WesternHAB/BioSampleBalloon/README.md

Bioaerosol Sampling Balloon
=======

Files and flight computer code for the 2019 bioaerosol sampling balloon, to be launched in August 2019

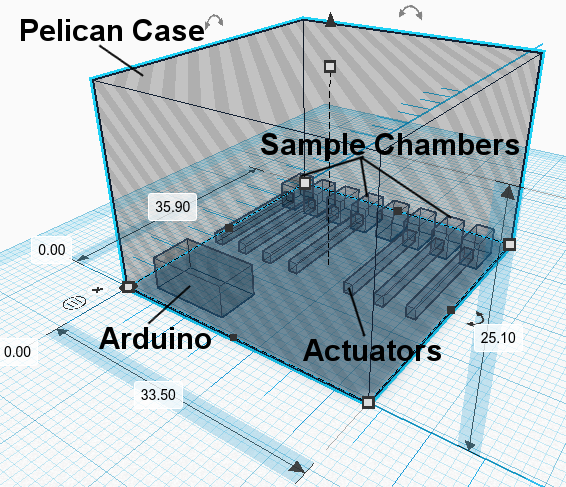
[picture p1: pdrreport/diagrams/payloadlayout_annot.png]
sketch of payload
