WesternHAB/BioSampleBalloon/pdrreport/diagrams/pdr.md

experimental design and procedures:
	* full system spec and diagrams
		* sample chamber
			* design of 1
			* how they all fit into the pelican case
		* computer arduino mega 2560
			shield provides ethernet and sd card
	* pre-flight
		* cooling test with less insulation to simulate colder temperatures
