WesternHAB/BioSampleBalloon/meetings/feb27.md

design meeting
===========

* over center latch design
https://www.amazon.ca/Southco-97-30-160-12-Over-Center-Series-Latches/dp/B013RO3R14/
* bag squeezed on lid
* push pen design
* need solidworks drawings

* rotorod dimensions 22mm x 1.6mm
