WesternHAB/BioSampleBalloon/pdrreport/COM.ods

reference point: | back left of pelican case, nearest to the chambers
case dimensions | X= 33.5cm | Y = 35.9cm | Z = 25.9
payload component | mass (g)
chambers | 7614.72
actuators | 770
arduino | 227
total mass | 8611.72
component position | x (cm) | y (cm) | z (cm)
chambers | 16 | 5.5 | 2
actuators | 16 | 19 | 2
arduino | 5.1 | 29.7 | 2
 | x (cm) | y (cm) | z (cm)
center of mass: | 14.15 | 4.86 | 1.77
