WesternHAB/BioSampleBalloon/IMG_20190429_135801.jpg

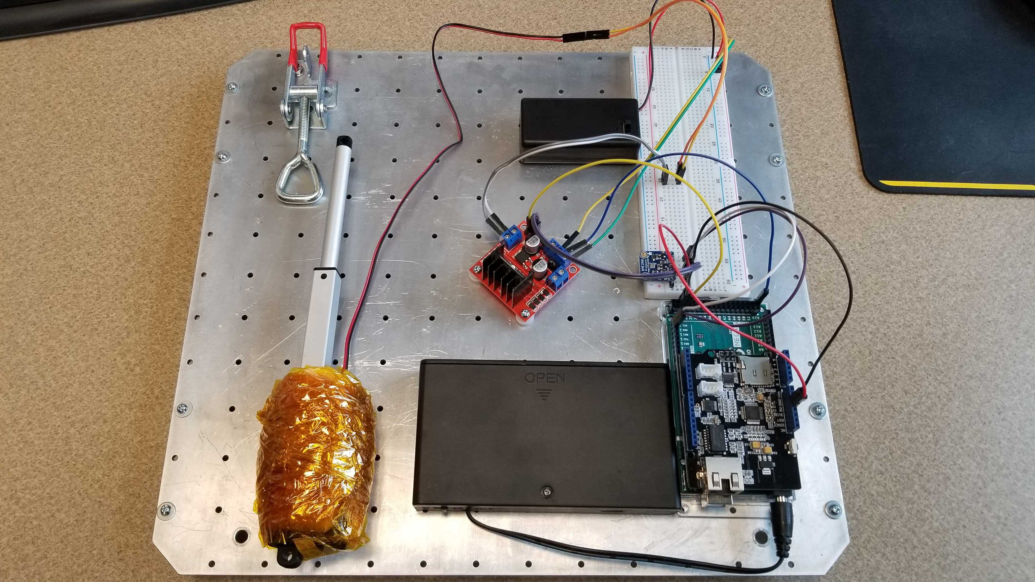
IMG_20190429_135801.jpg
