WesternHAB/BioSampleBalloon/PayloadDesign/61966530_412056996304490_6517414697593995264_n.jpg

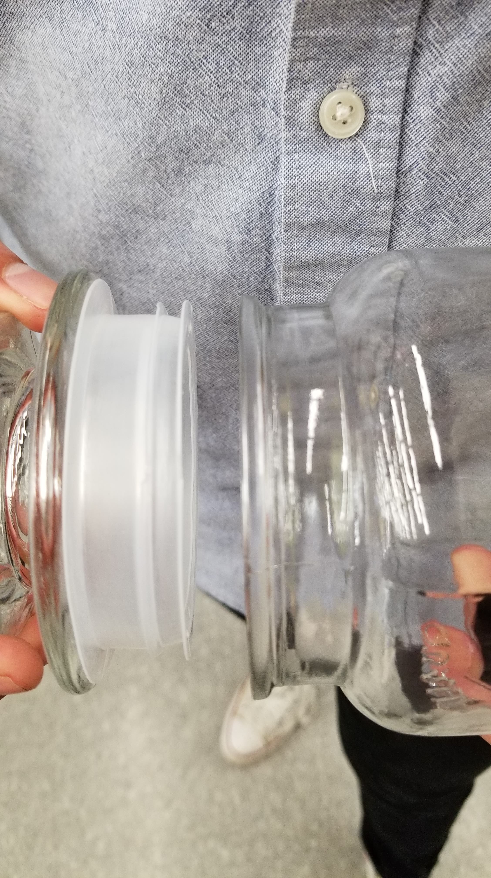
PayloadDesign/61966530_412056996304490_6517414697593995264_n.jpg
