WesternHAB/BioSampleBalloon/PayloadDesign/62052030_332287614118805_2269187434732322816_n.jpg

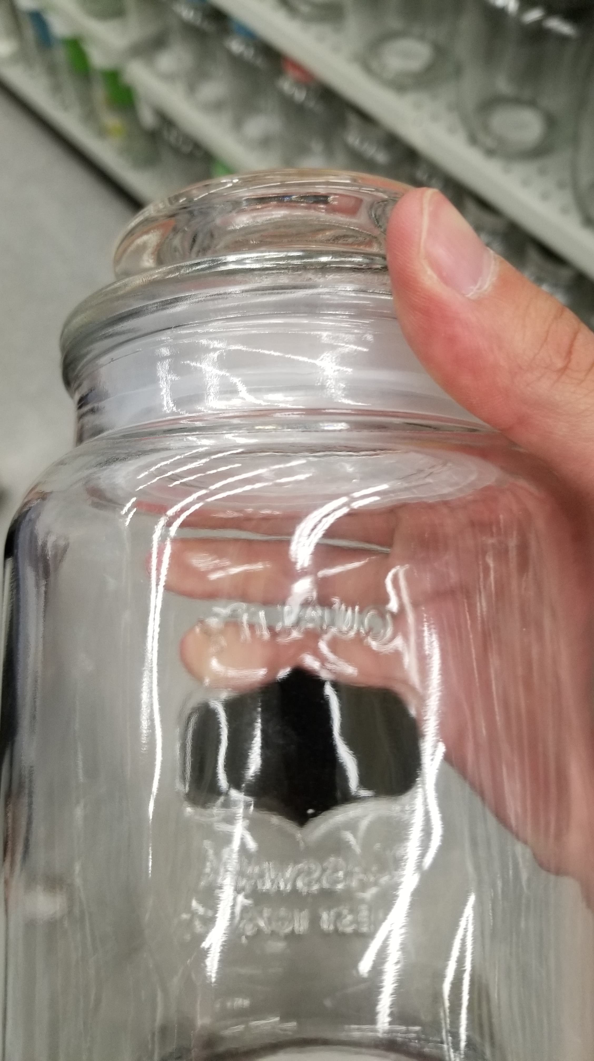
PayloadDesign/62052030_332287614118805_2269187434732322816_n.jpg
