WesternHAB/BioSampleBalloon/PayloadDesign/actuonix-p16-150-256-12-p-1.snapshot.5/Actuonix7.PNG

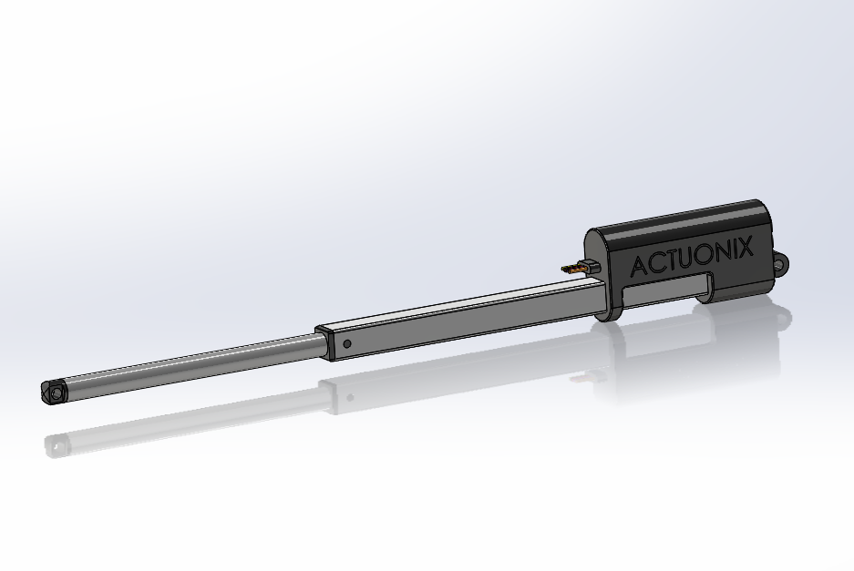
PayloadDesign/actuonix-p16-150-256-12-p-1.snapshot.5/Actuonix7.PNG
