WesternHAB/BioSampleBalloon/PayloadDesign/Chamber/v2/Door.jpg

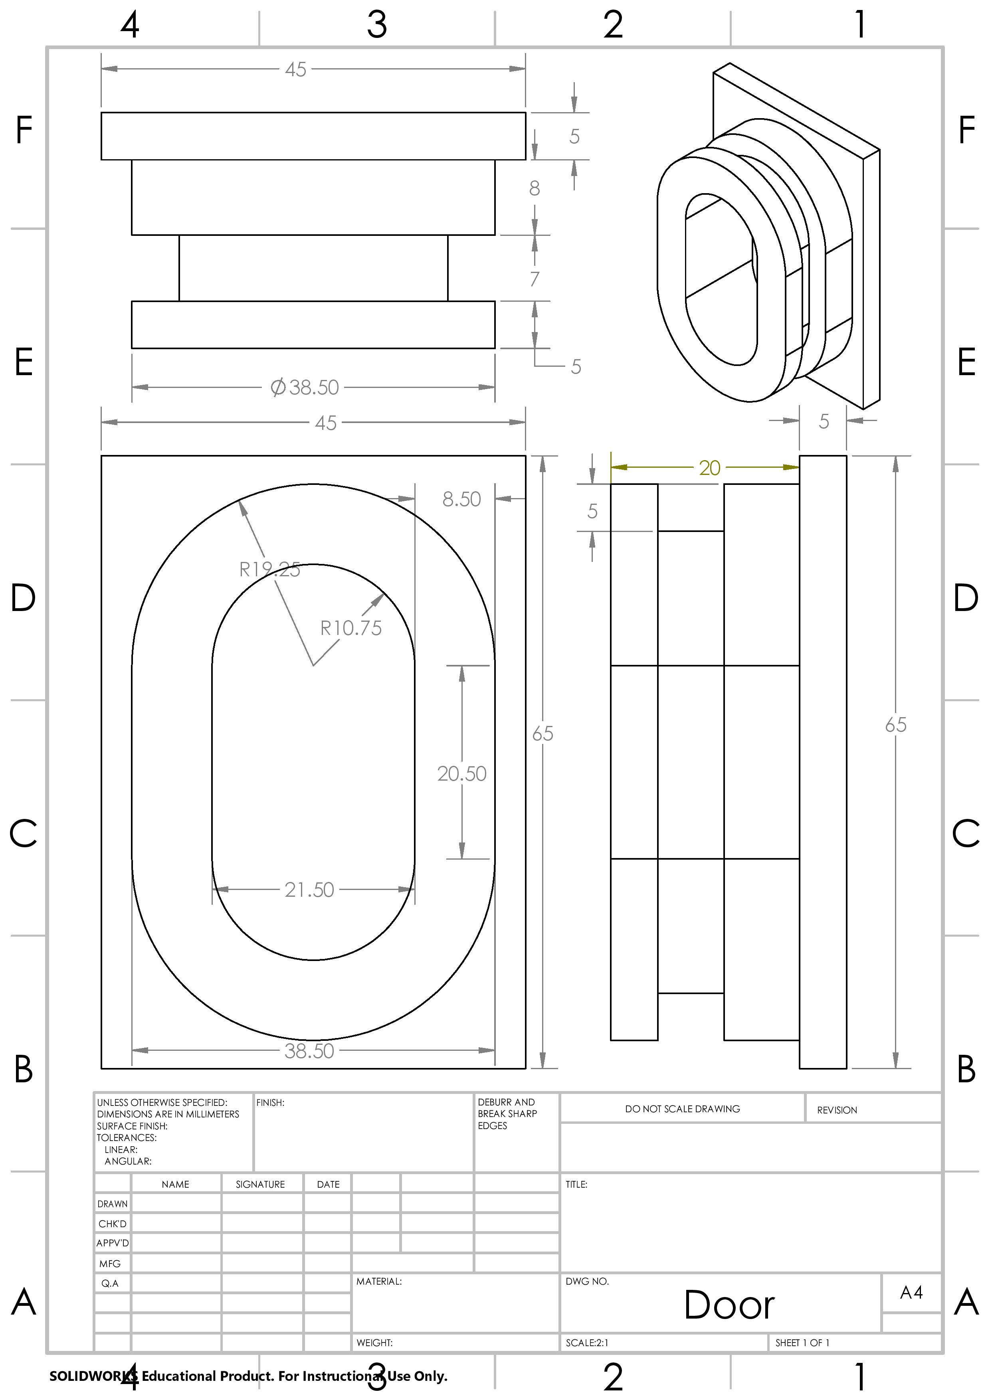
PayloadDesign/Chamber/v2/Door.jpg
