WesternHAB/BioSampleBalloon/PayloadDesign/door.PNG

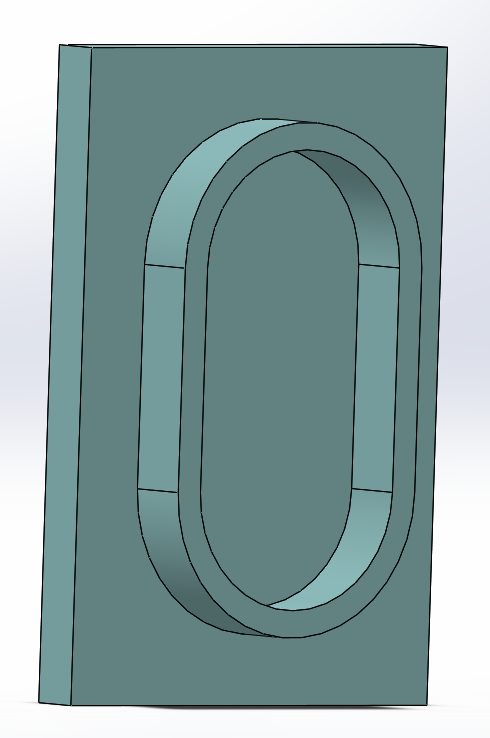
PayloadDesign/door.PNG
