WesternHAB/BioSampleBalloon/PayloadDesign/exploded2.PNG

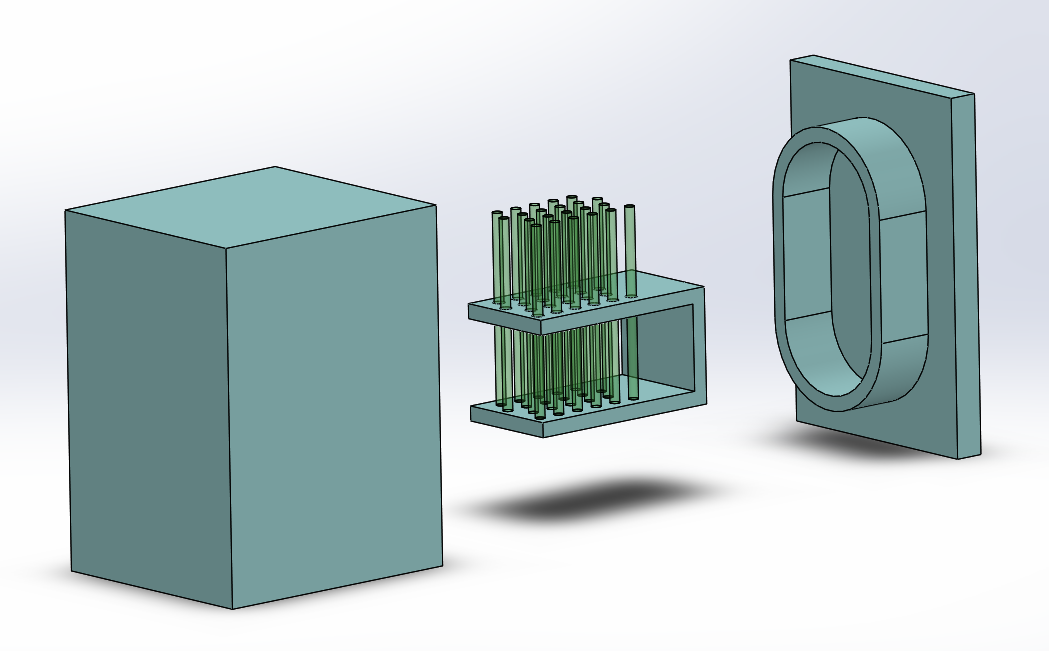
PayloadDesign/exploded2.PNG
