WesternHAB/BioSampleBalloon/PayloadDesign/exploded.PNG

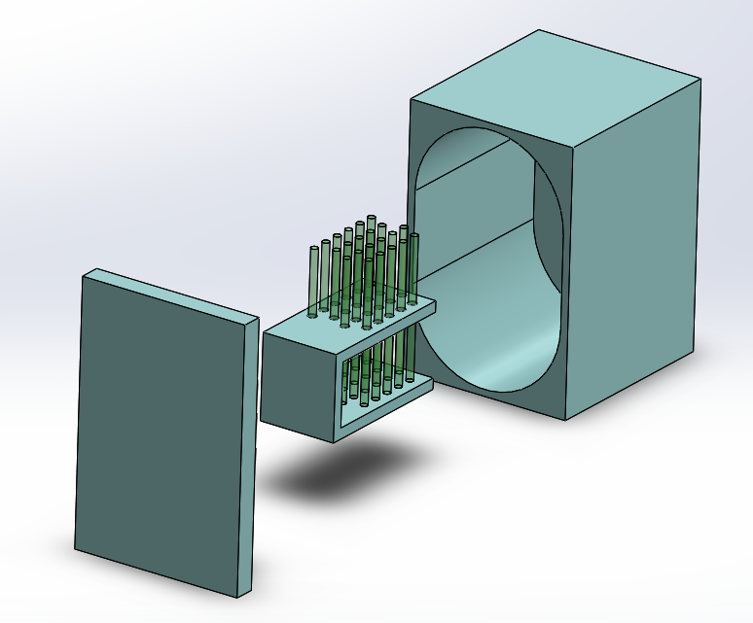
PayloadDesign/exploded.PNG
