WesternHAB/BioSampleBalloon/PayloadDesign/layout.PNG

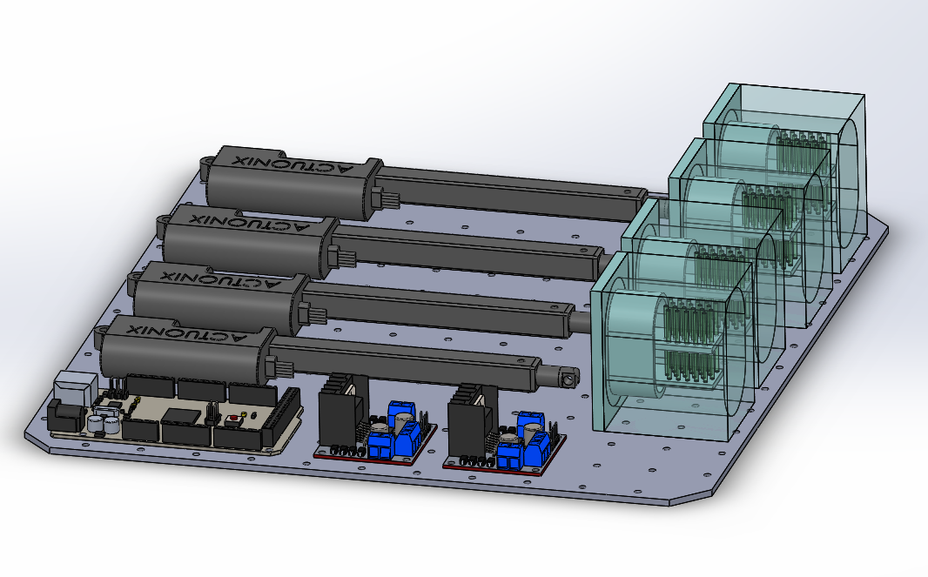
PayloadDesign/layout.PNG
