WesternHAB/BioSampleBalloon/PayloadDesign/payloaddeck.jpg

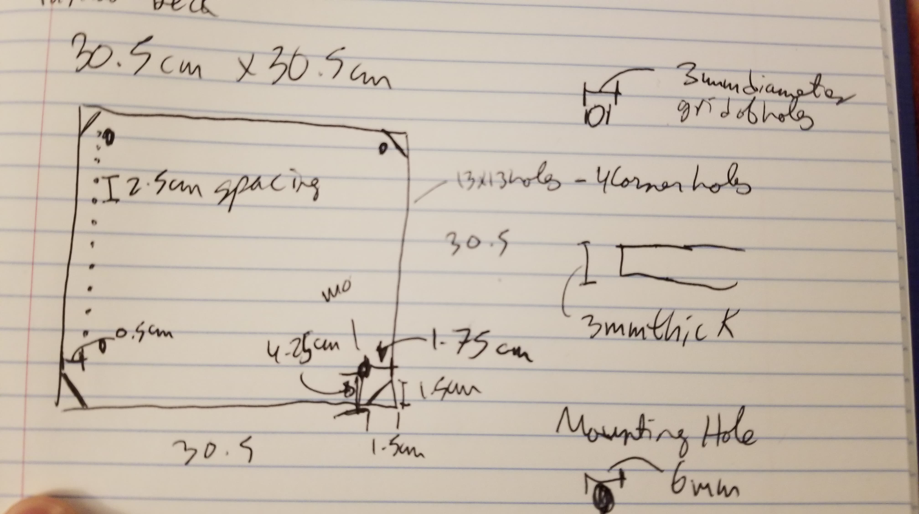
PayloadDesign/payloaddeck.jpg
