WesternHAB/BioSampleBalloon/PayloadDesign/ridgedchamber.PNG

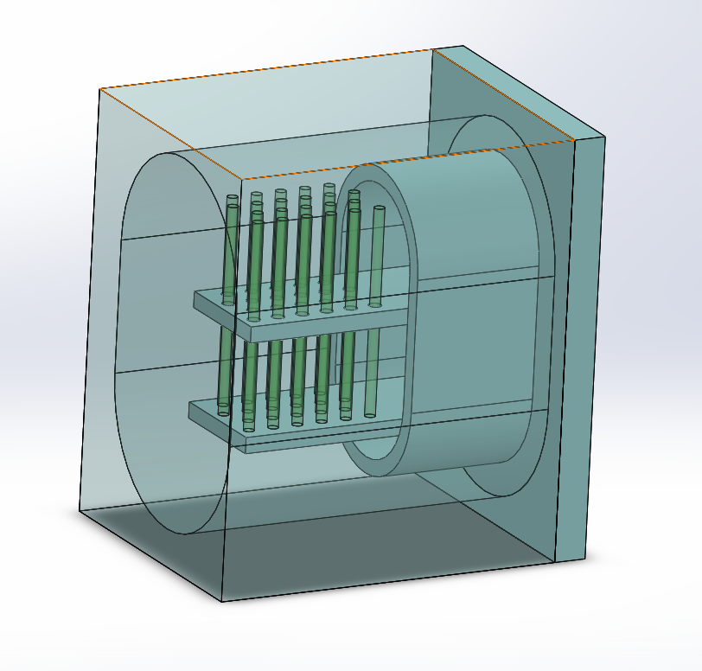
PayloadDesign/ridgedchamber.PNG
