WesternHAB/BioSampleBalloon/PayloadDesign/st-st-toggle-latch/Renderings/ST ST TOGGLE LATCH.jpg

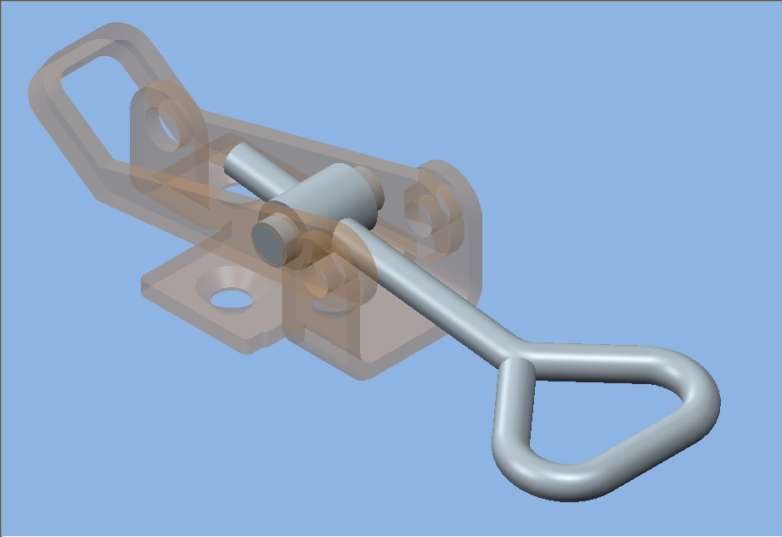
PayloadDesign/st-st-toggle-latch/Renderings/ST ST TOGGLE LATCH.jpg
