WesternHAB/BioSampleBalloon/payloadplate.jpg

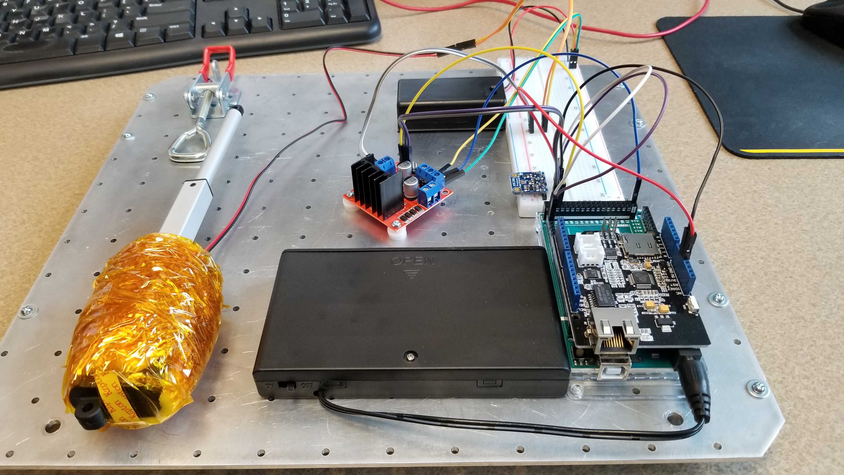
payloadplate.jpg
