WesternHAB/BioSampleBalloon/pdrreport/0001.jpg

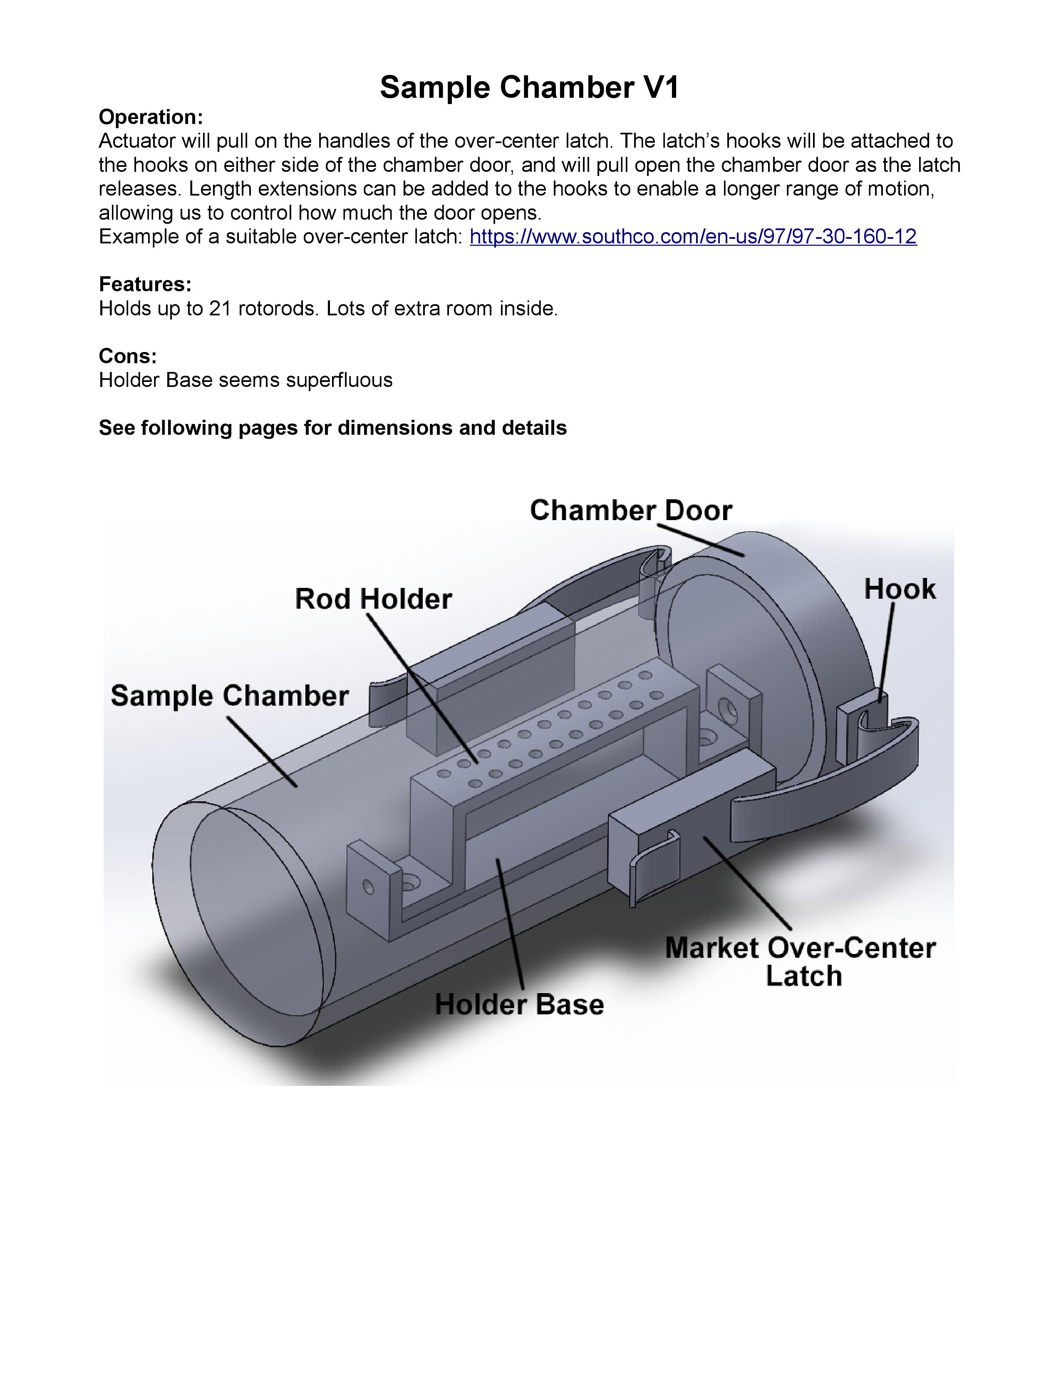
pdrreport/0001.jpg
