WesternHAB/BioSampleBalloon/pdrreport/0002.jpg

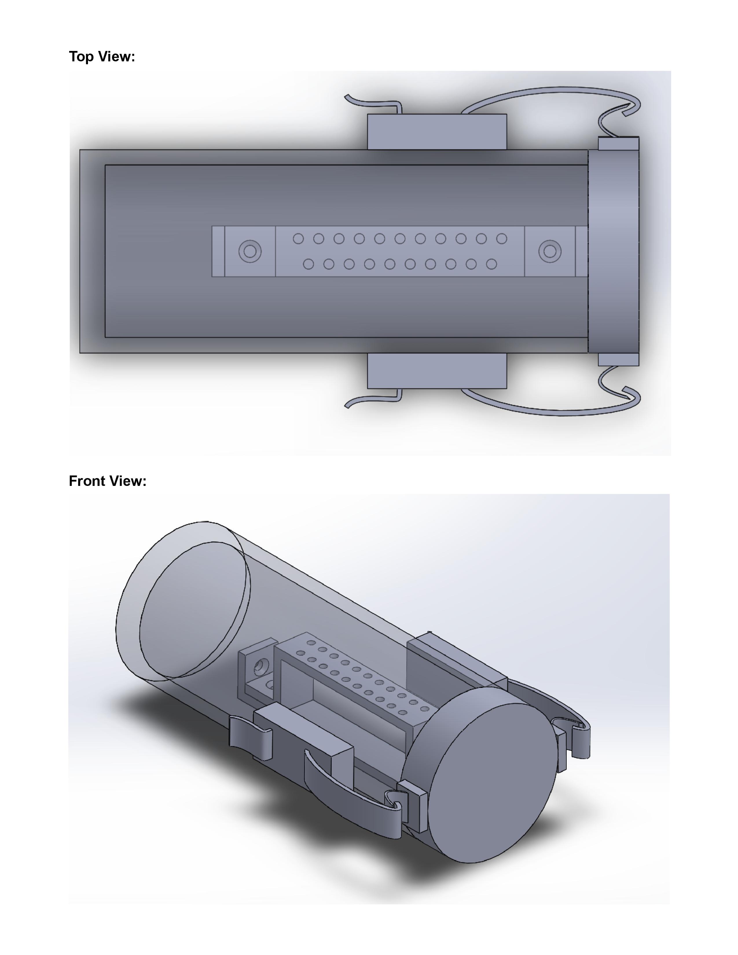
pdrreport/0002.jpg
