WesternHAB/BioSampleBalloon/pdrreport/diagrams/chamber.png

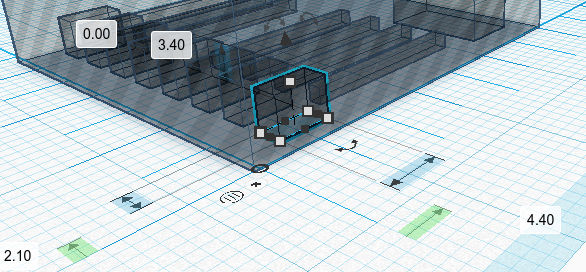
pdrreport/diagrams/chamber.png
