WesternHAB/BioSampleBalloon/pdrreport/diagrams/ChamberAndActuator.png

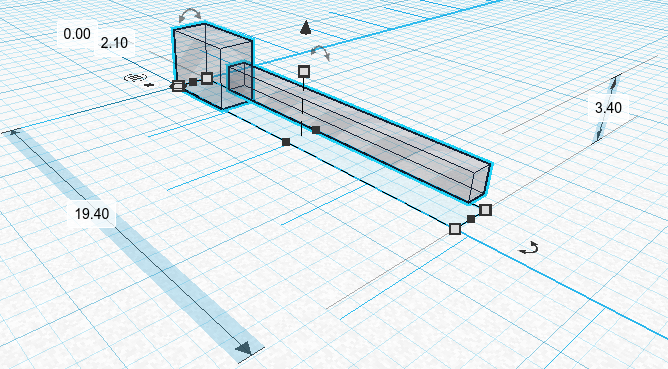
pdrreport/diagrams/ChamberAndActuator.png
