WesternHAB/BioSampleBalloon/photos/58381048_2682178798699231_8591205000376483840_n.jpg

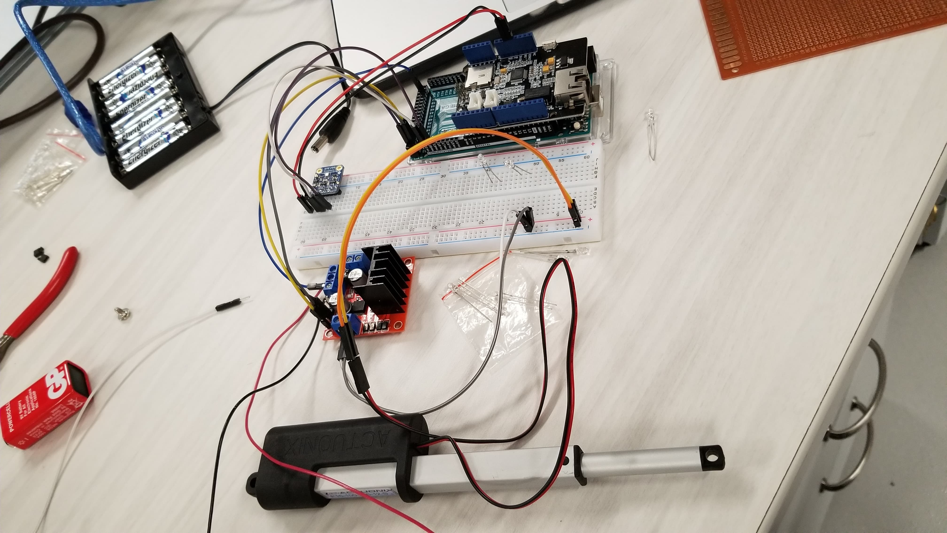
photos/58381048_2682178798699231_8591205000376483840_n.jpg
