WesternHAB/BioSampleBalloon/photos/58543091_2698857160141116_8218095826958811136_n.jpg

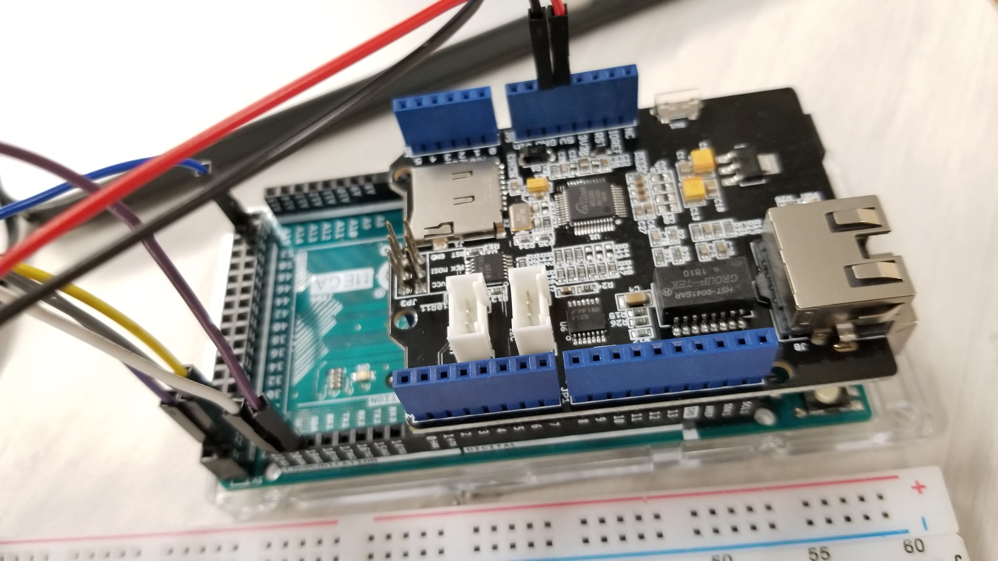
photos/58543091_2698857160141116_8218095826958811136_n.jpg
