WesternHAB/BioSampleBalloon/photos/58796900_1178005832367240_1408349695100583936_n.jpg

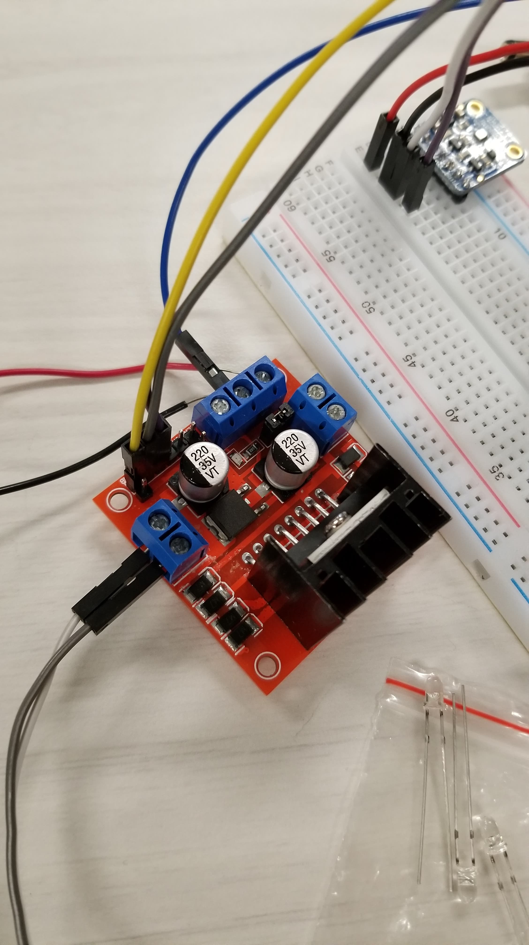
photos/58796900_1178005832367240_1408349695100583936_n.jpg
