WesternHAB/BioSampleBalloon/photos/chamb1.jpg

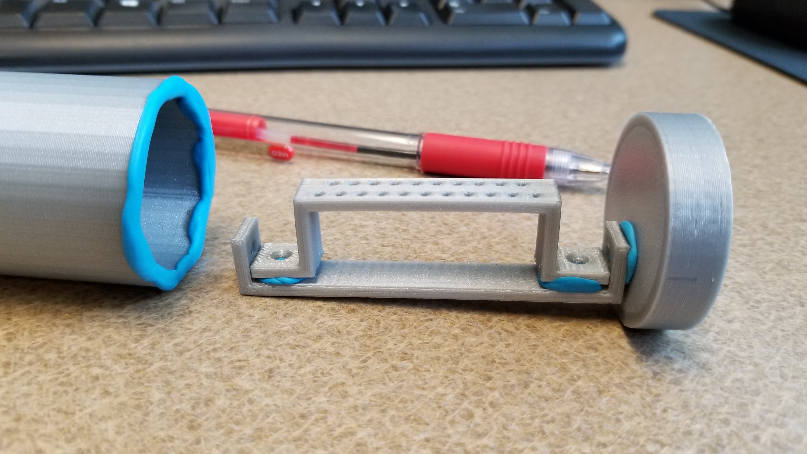
photos/chamb1.jpg
