WesternHAB/BioSampleBalloon/photos/chamb2.jpg

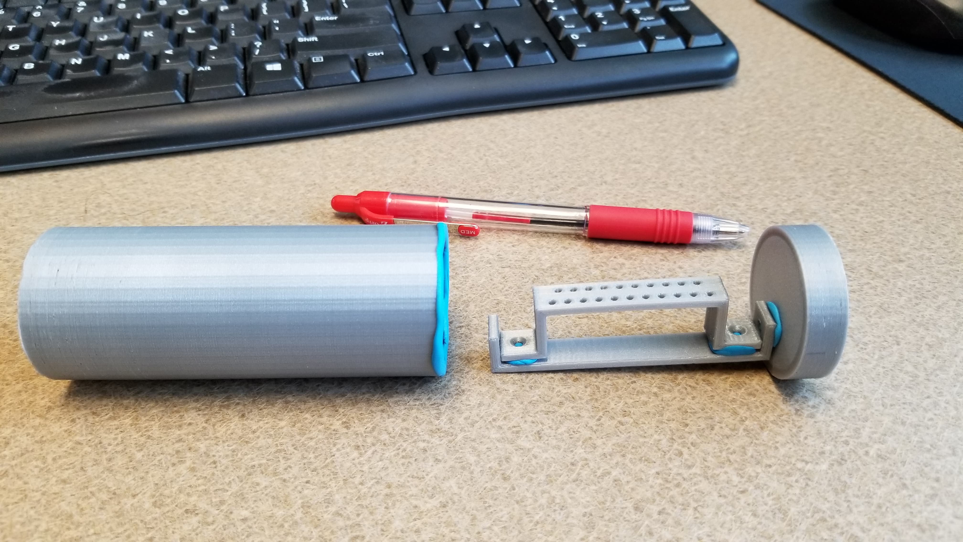
photos/chamb2.jpg
