WesternHAB/BioSampleBalloon/photos/chamb3.jpg

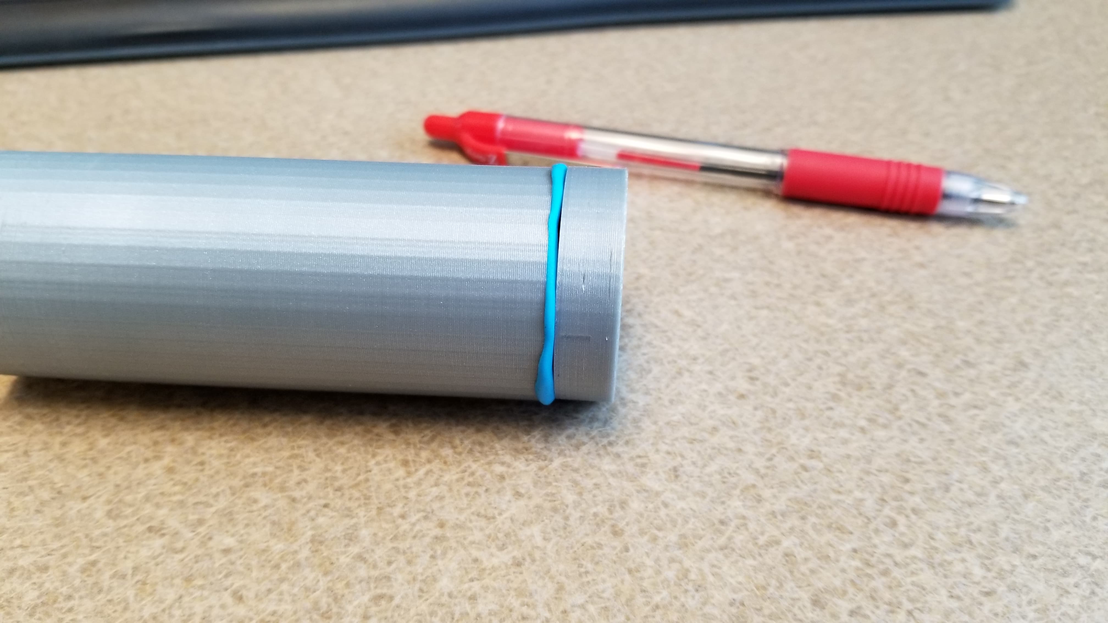
photos/chamb3.jpg
