WesternHAB/BioSampleBalloon/photos/chamb4.jpg

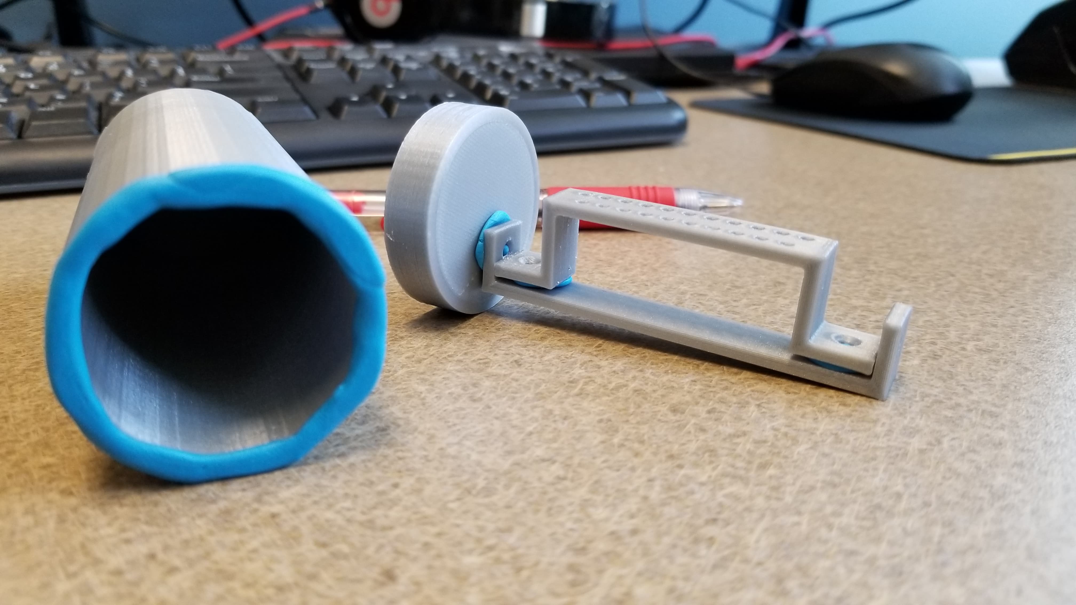
photos/chamb4.jpg
