WesternHAB/BioSampleBalloon/Bioaerosol-Sampling-Costs-tentative.xlsx

Item | Qty | Unit Price | Total Price (CAD) | Link
Arduino MEGA 2560 | 1 | 45.99 | 45.99 | https://www.robotshop.com/ca/en/arduino-mega-2560-microcontroller-rev3.html
L298 Dual H-Bridge DC Motor Controller | 4 | 10.36 | 41.44 | https://www.robotshop.com/ca/en/l298-dual-h-bridge-dc-motor-controller.html
Linear Actuators | 7 | 108.78 | 761.46 | https://www.robotshop.com/ca/en/firgelli-technologies-l12-100-100-06-p.html
Ethernet Shield | 1 | 32.5 | 32.5 | https://www.adafruit.com/product/2971
SD card | 2 | 11.35 | 22.7 | https://www.amazon.ca/Sandisk-Class-UHS-I-Memory-SDSDUNC-016G-GN6IN/dp/B0143RTB1E
GPS Module | 1 | 23.00 | 23.00 | https://www.amazon.ca/Robojax-U-blox-NEO-6M-Module-Antenna/dp/B073MFYL8B
Camera | 1 | 16.59 | 16.59 | https://www.adafruit.com/product/3202
Temperature sensor | 1 | 19.95 | 19.95 | https://www.adafruit.com/product/2652
Bioaerosol sampling rods | 1 | 159.25 | 159.25 | https://www.pollen.com/help/rotorod
Silicone Grease | 1 | 47.78 | 47.78 | https://www.pollen.com/help/rotorod
Total |  |  | 1170.66
