WesternHAB/BioSampleBalloon/pdrreport/Mass and Power Budget.xlsx

Sheet: Mass Budget
Component | Status | Qty | Unit Mass | Total Mass | Mass Fraction |  | Volume (cm^3) | Material Density | Mass (g)
Structure and Mechanisms
Aluminum Structure | M0 | 8 | 74.44 | 595.52 |  | Chamber Body | 20 | 2.7 | 54
P16 Linear Actuator | M1 | 7 | 110 | 770 |  | Chaber Door | 4 | 2.7 | 10.8
Luer Lock | M1 | 8 | 10 | 80 |  | Holder base | 2.475 | 2.7 | 6.6825
Syringe Filters | M1 | 8 | 5 | 40 |  | Rod Holder | 1.097 | 2.7 | 2.9619
Latches | M1 | 16 | 431.2 | 6899.2 |  | Latch | 56 | 7.7 | 431.2
Subtotal |  |  |  | 8384.72 | 92.06370121% | Total | 27.572 | 18.5 | 505.6444
Experiment Components
Sampling Rods | M0 | 160 | 1 | 160
Subtotal |  |  |  | 160 | 1.756789993%
Electronics and Data Logging
Arduino Mega 2560 | M1 | 1 | 37 | 37
L298 Actuator Control Boards | M1 | 4 | 35 | 140
Ethernet Shield | M1 | 1 | 25 | 25 |  |  |  |  | 936.8
SD Card | M1 | 2 | 2 | 4 |  |  |  |  | 7494.4
GPS Module | M1 | 1 | 18 | 18
BME 280 Environmental Sensor | M1 | 1 | 1 | 1
Mini Spy Camera | M1 | 1 | 2.8 | 2.8
Subtotal |  |  |  | 227.8 | 2.501229753%
Thermal Insulation
Thermal Insulation | M1 | 1 | 35 | 35
Kapton Tape | E | 1 | 100 | 100
Subtotal |  |  |  | 135 | 1.482291557%
Miscellaneous |  |  |  |  |  |  |  | 18.5
Wires/Cables | E | 1 | 100 | 100
Screws/Rivets/Fasteners | E | 1 | 100 | 100
Subtotal |  |  |  | 200 | 2.195987492%
Total Mass |  |  |  | 9107.52 | 100%
Target Mass |  |  |  | 12000
Margin |  |  |  | 2892.48 | 24.104%

Sheet: Power Budget
Component | Qty | Unit Idle Power Consumption (W) | Unit Peak Power Consumption (W) | Idle uptime | Peak uptime | Total Energy Consumption (Wh) | Energy Fraction
Arduino | 1 | 0.4 | 1 | 0% | 100% | 14 | 78.45417656%
Linear Actuators | 7 | 0 | 6.24 | 99.70% | 0.30% | 0.364 | 2.039808591%
GPS Module | 1 | 0 | 0.2412 | 0% | 100% | 3.3768 | 18.92314739%
Camera | 1 | 0.4 | 0.55 | 99.70% | 0.30% | 0.09625 | 0.5393724639%
BME 280 Environmental Sensor | 1 | 3.3e-06 | 0.0001188 | 0% | 100% | 0.0016632 | 0.009320356176%
Ethernet Shield | 1 | 4.29e-05 | 0.0004356 | 0% | 100% | 0.0060984 | 0.03417463931%
Total |  |  |  |  |  | 17.8448116 | 100%
Target |  |  |  |  |  | 30
Margin |  |  |  |  |  | 12.1551884 | 40.51729467%
