WesternHAB/BioSampleBalloon/PayloadDesign/Chamber/O ring Groove/ChamberAssembly.SLDASM

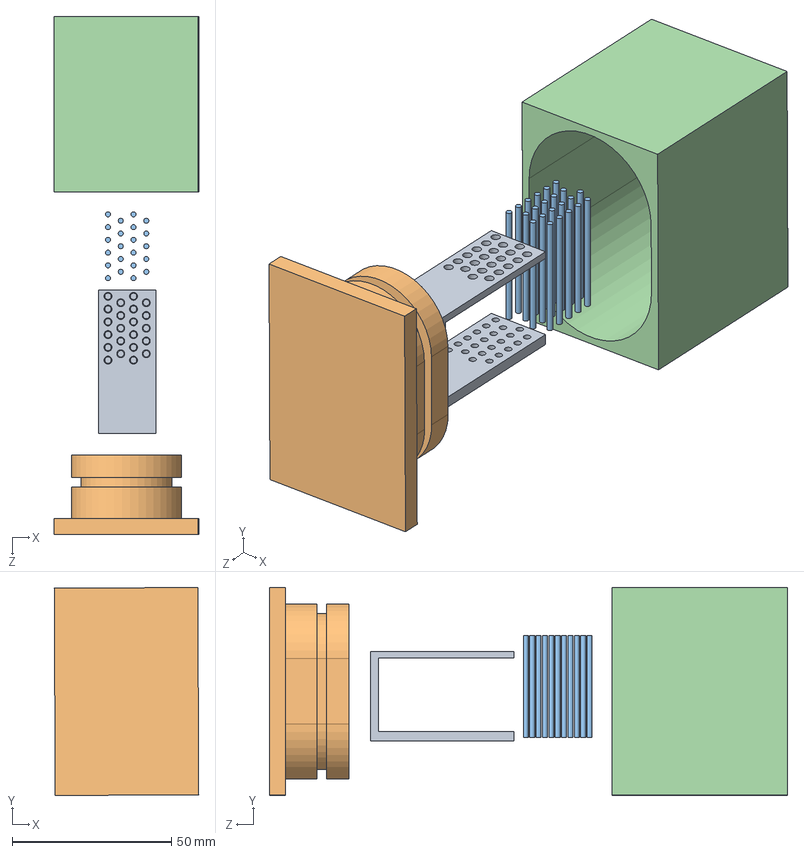
[picture p47: CAD file, 2019-07-03]
PayloadDesign/Chamber/O ring Groove/ChamberAssembly.SLDASM
45.3 x 65.2 x 162.5 mm
RodHolder
Door
Rotorod x 22
Chamber
