WesternHAB/BioSampleBalloon/PayloadDesign/st-st-toggle-latch/latch-702ss_asm.stp

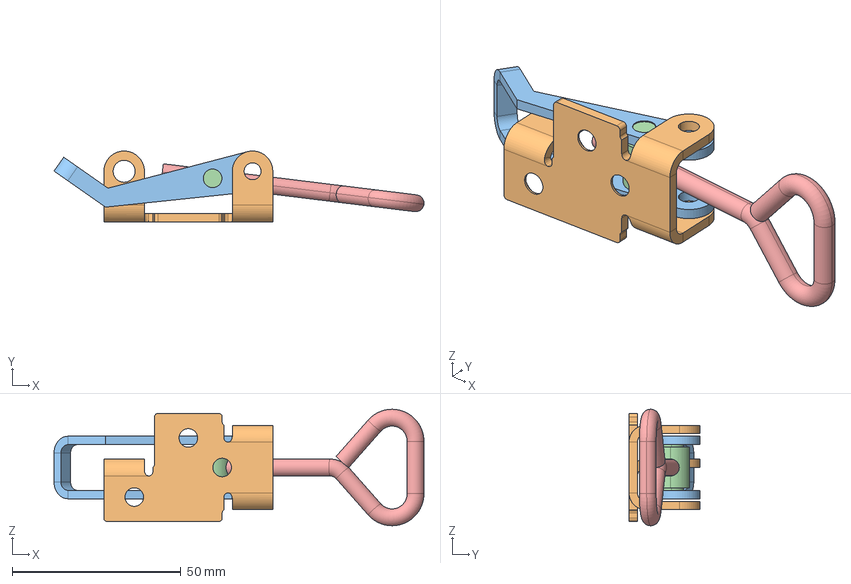
[picture p48: CAD file, 2019-07-03]
PayloadDesign/st-st-toggle-latch/latch-702ss_asm.stp
109.5 x 21.0 x 34.5 mm
LATCH_BASE-702SS
LATCH_TOGGLE-702SS
LATCH_PIN-702SS
LATCH_HOOK-702SS
