WesternHAB/BioSampleBalloon/PayloadDesign/actuonix-p16-150-256-12-p-1.snapshot.5/Actuonix-P16-150-256-12-P.SLDASM

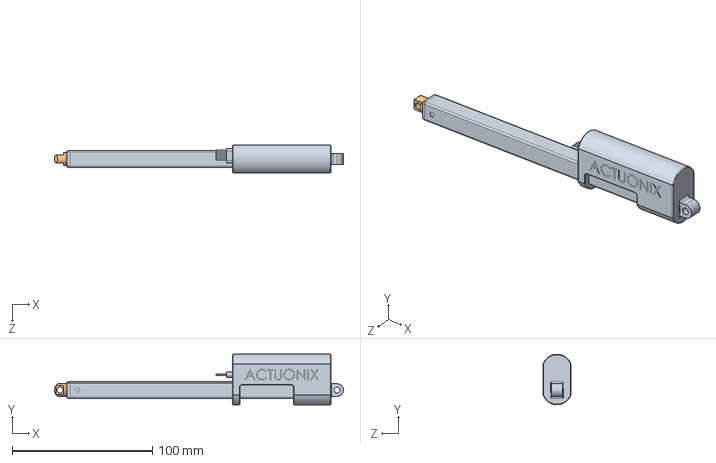
[picture p49: CAD file, 2019-06-05]
PayloadDesign/actuonix-p16-150-256-12-p-1.snapshot.5/Actuonix-P16-150-256-12-P.SLDASM
205.9 x 36.0 x 20.0 mm
xPCR Actuonix-P16-150-256-12-P-Housing
xPCR Actuonix-P16-150-256-12-P-Shaft
