WesternHAB/BioSampleBalloon/PayloadDesign/Chamber/v2/L-bracketAssembly.SLDASM

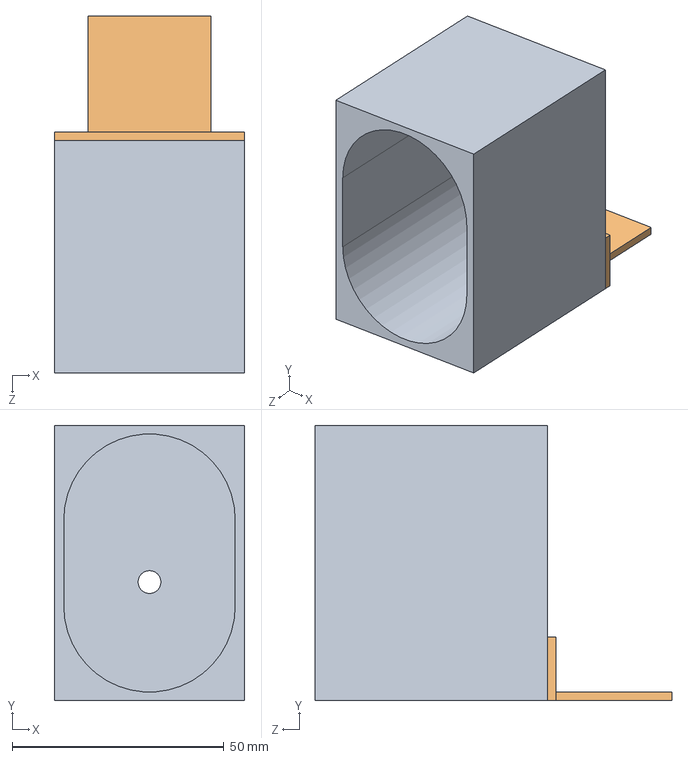
[picture p50: CAD file, 2019-07-11]
PayloadDesign/Chamber/v2/L-bracketAssembly.SLDASM
45.0 x 65.0 x 84.4 mm
Chamber
L-Bracket
