WesternHAB/BioSampleBalloon/PayloadDesign/Chamber/v2/ChamberAssembly.SLDASM

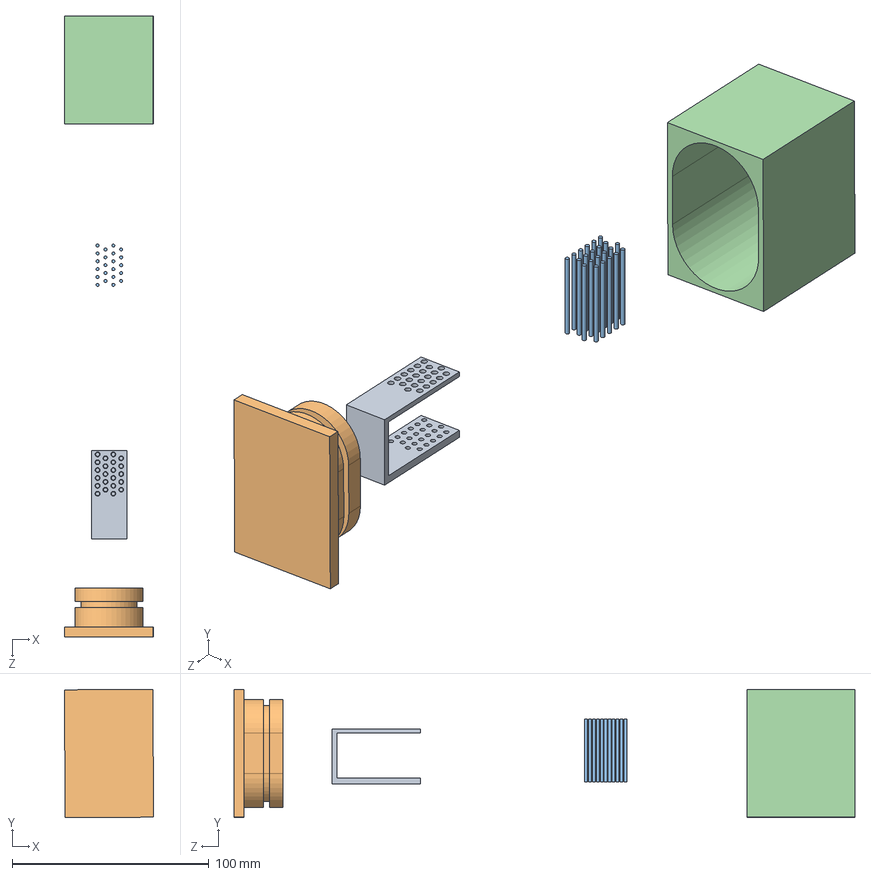
[picture p51: CAD file, 2019-07-03]
PayloadDesign/Chamber/v2/ChamberAssembly.SLDASM
45.3 x 65.2 x 315.9 mm
RodHolder
Door
Rotorod x 22
Chamber
