WesternHAB/BioSampleBalloon/PayloadDesign/PayloadAssembly-July29/BoxActuatorHeatingPad.SLDASM

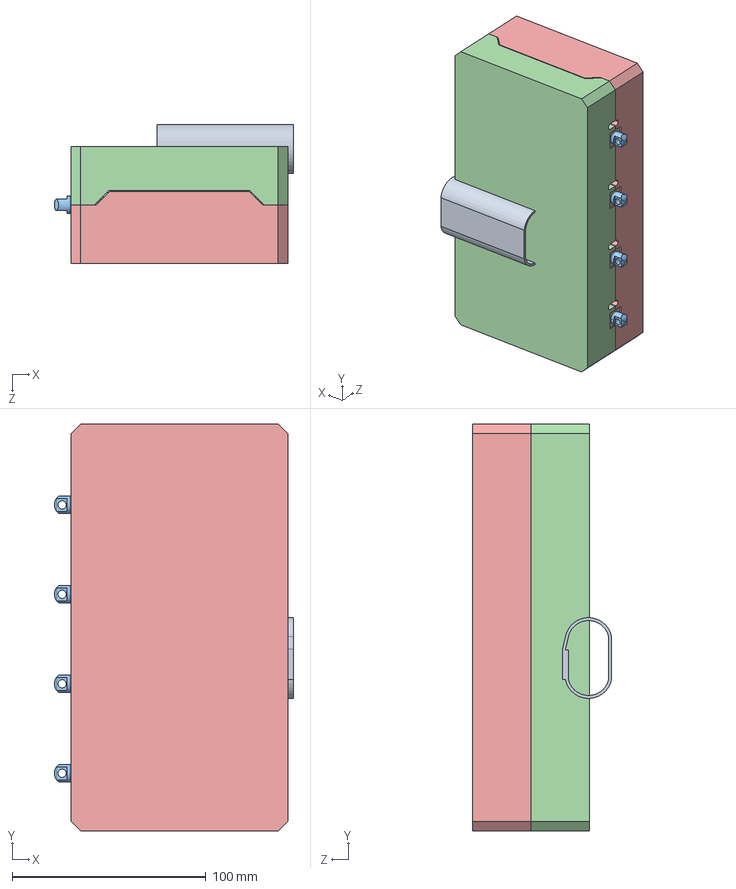
[picture p52: CAD file, 2019-08-02]
PayloadDesign/PayloadAssembly-July29/BoxActuatorHeatingPad.SLDASM
123.4 x 210.0 x 71.9 mm
HeatingPad x 4
ACTUONIX-P16-50-64-12-P_HOUSING x 4
ACTUONIX-P16-50-64-12-P_ROD x 4
BoxBottom02
BoxTop03
