WesternHAB/BioSampleBalloon/PayloadDesign/PayloadAssembly-July29/ChamberAssembly.SLDASM

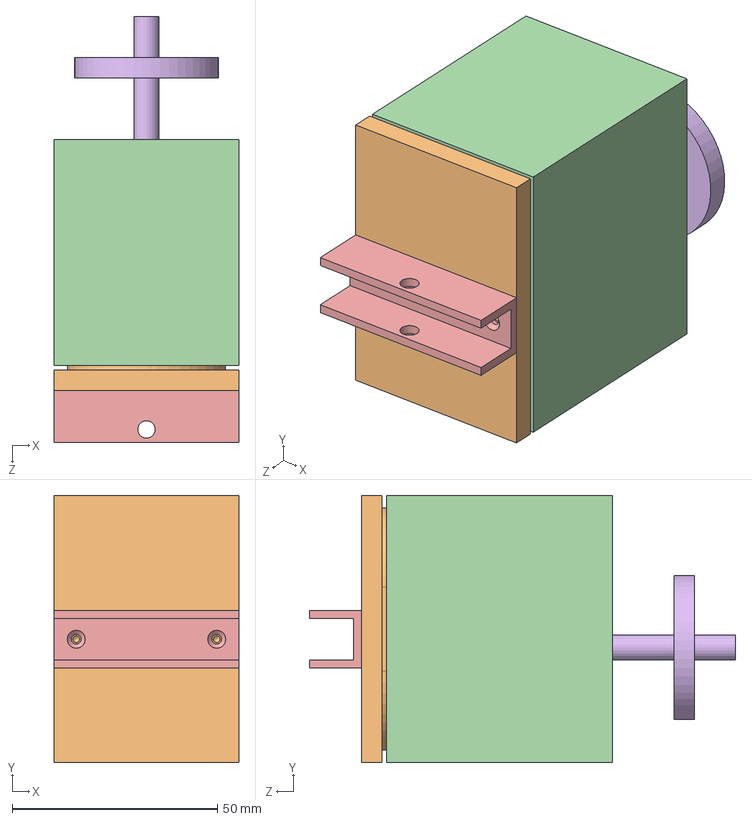
[picture p53: CAD file, 2019-08-02]
PayloadDesign/PayloadAssembly-July29/ChamberAssembly.SLDASM
45.0 x 65.0 x 103.7 mm
RodHolder
Door
Rotorod x 22
Chamber
DoorBracket
SyringeFilter
