WesternHAB/BioSampleBalloon/PayloadDesign/PayloadAssembly-July29/PayloadwBox.SLDASM

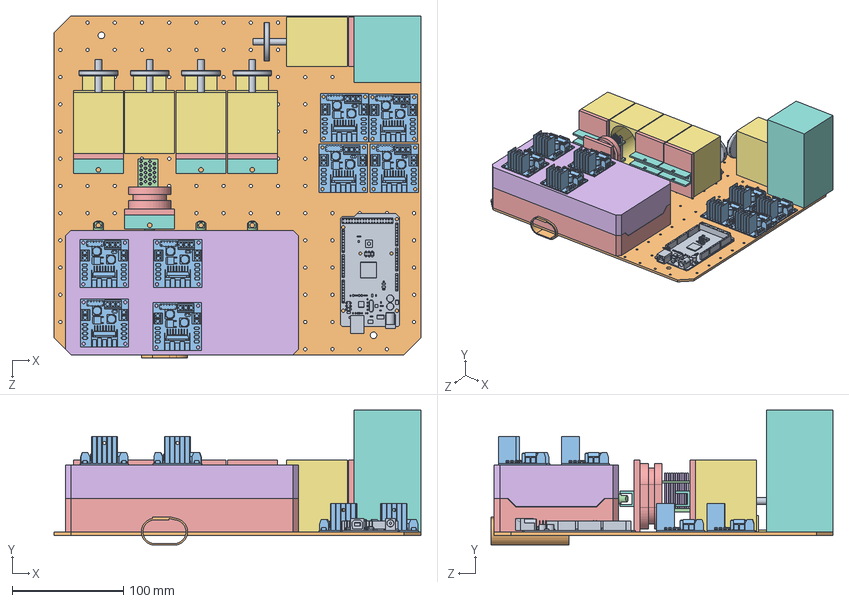
[picture p54: CAD file, 2019-08-02]
PayloadDesign/PayloadAssembly-July29/PayloadwBox.SLDASM
330.0 x 121.5 x 307.9 mm
ArduinoMega
deck
HBridge x 8
RodHolder x 5
Door x 5
Rotorod x 110
Chamber x 5
DoorBracket x 5
SyringeFilter x 5
HeatingPad x 4
ACTUONIX-P16-50-64-12-P_HOUSING x 4
ACTUONIX-P16-50-64-12-P_ROD x 4
BoxBottom02
BoxTop03
L-Bracket x 4
NOGO-Zone
