WesternHAB/BioSampleBalloon/PayloadDesign/PayloadAssembly-July29/ACTUONIX-P16-50-64-12-P.SLDASM

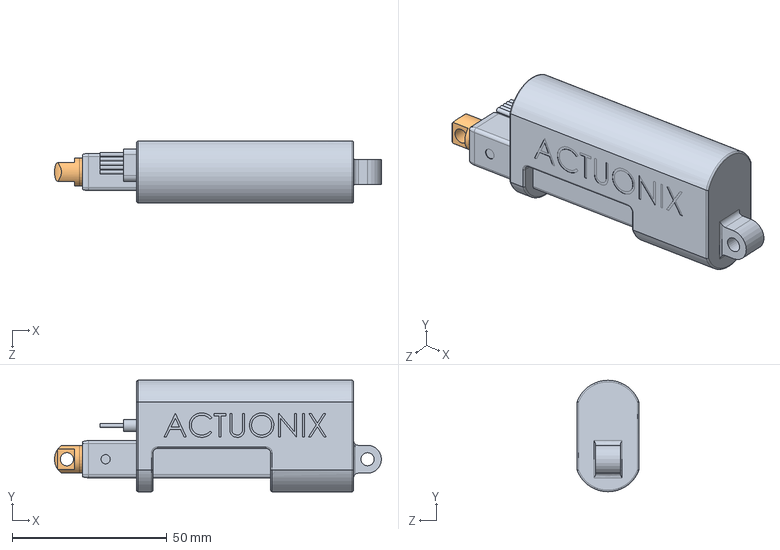
[picture p55: CAD file, 2019-08-02]
PayloadDesign/PayloadAssembly-July29/ACTUONIX-P16-50-64-12-P.SLDASM
105.5 x 36.0 x 20.0 mm
ACTUONIX-P16-50-64-12-P_HOUSING
ACTUONIX-P16-50-64-12-P_ROD
