WesternHAB/BioSampleBalloon/PayloadDesign/actuonix-p16-150-256-12-p-1.snapshot.5/Actuonix-P16-150-256-12-P-Housing.SLDPRT

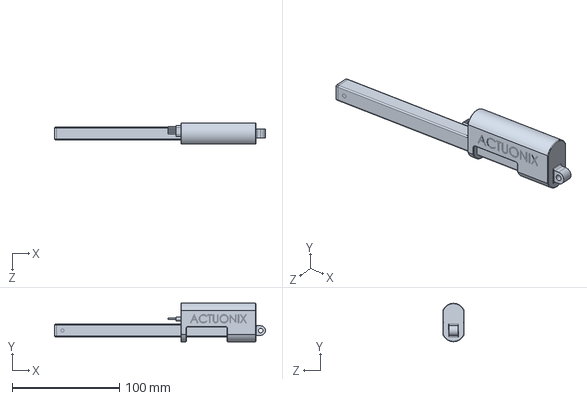
[picture p56: CAD file, 2019-06-05]
PayloadDesign/actuonix-p16-150-256-12-p-1.snapshot.5/Actuonix-P16-150-256-12-P-Housing.SLDPRT
196.9 x 36.0 x 20.0 mm
