WesternHAB/BioSampleBalloon/PayloadDesign/arduino-mega-2560--1.snapshot.8/ArduinoMega_STEP_AP203.STEP

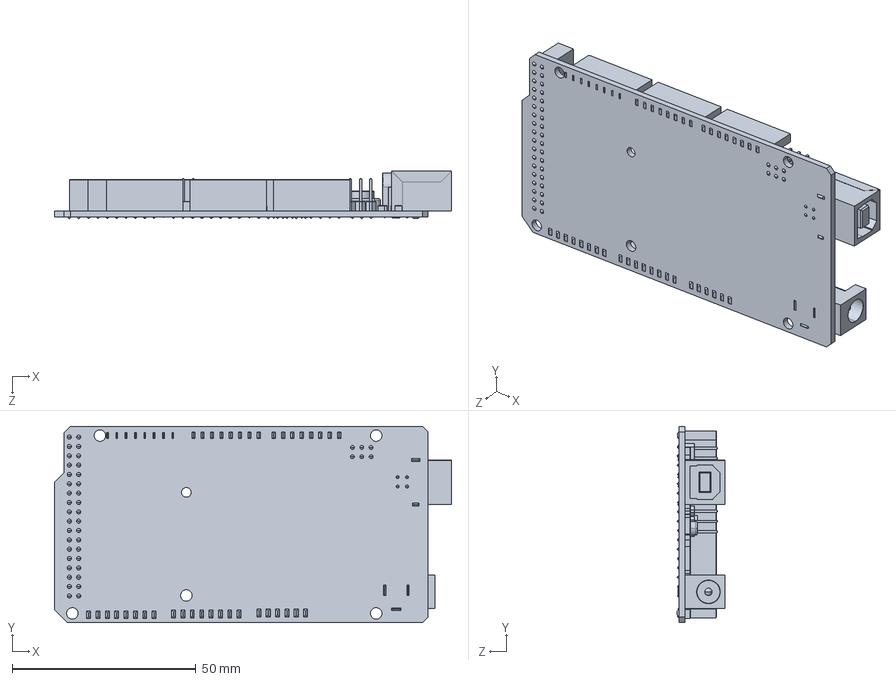
[picture p57: CAD file, 2019-07-03]
PayloadDesign/arduino-mega-2560--1.snapshot.8/ArduinoMega_STEP_AP203.STEP
107.9 x 53.4 x 13.0 mm
