WesternHAB/BioSampleBalloon/PayloadDesign/Chamber/printermodels/RodHolder.STL

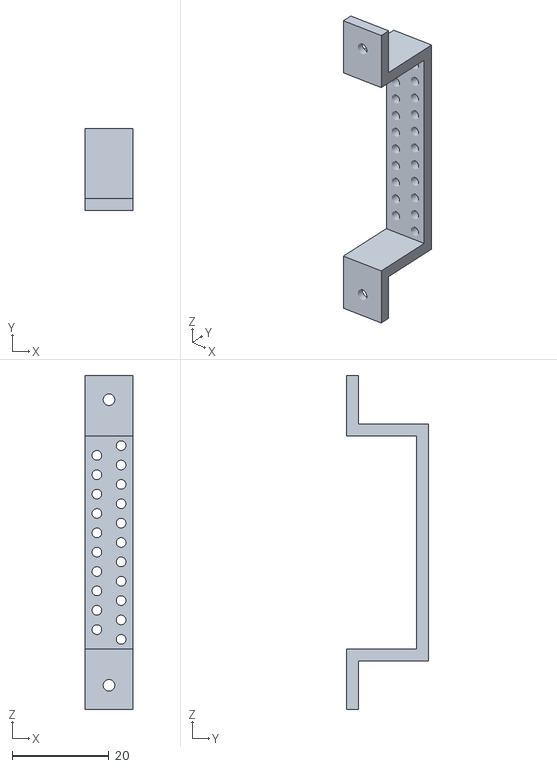
[picture p58: CAD file, 2019-04-02]
PayloadDesign/Chamber/printermodels/RodHolder.STL
10.0 x 17.0 x 69.0
