WesternHAB/BioSampleBalloon/PayloadDesign/Chamber/v2/Door.SLDPRT

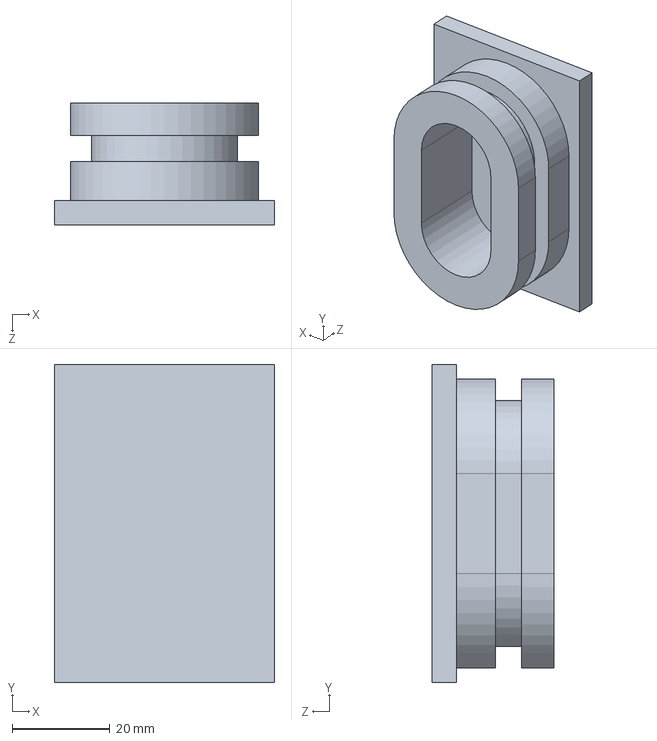
[picture p59: CAD file, 2019-07-29]
PayloadDesign/Chamber/v2/Door.SLDPRT
45.0 x 65.0 x 25.0 mm
