WesternHAB/BioSampleBalloon/PayloadDesign/l298n-h-bridge-motor-driver-1.snapshot.2/L298N Motor Driver.STEP

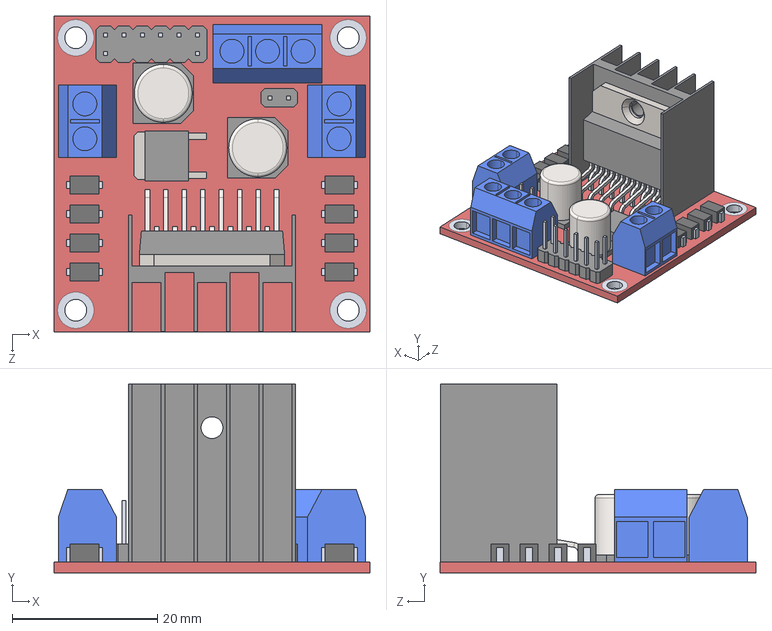
[picture p60: CAD file, 2019-07-03]
PayloadDesign/l298n-h-bridge-motor-driver-1.snapshot.2/L298N Motor Driver.STEP
43.5 x 26.0 x 43.5 mm
