WesternHAB/BioSampleBalloon/PayloadDesign/PayloadAssembly-July29/Rotorod.SLDPRT

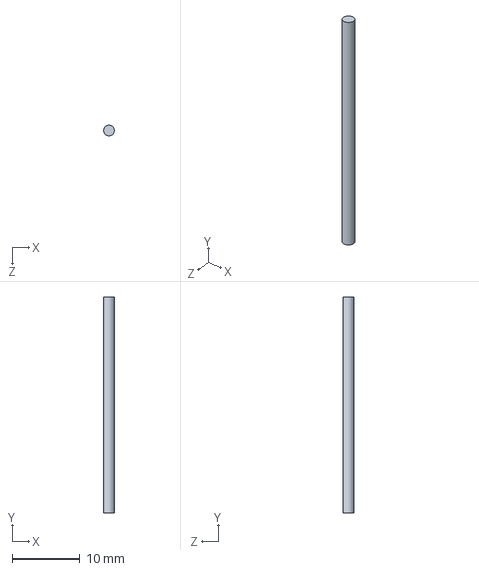
[picture p61: CAD file, 2019-08-02]
PayloadDesign/PayloadAssembly-July29/Rotorod.SLDPRT
1.60 x 32.0 x 1.60 mm
