WesternHAB/BioSampleBalloon/PayloadDesign/Chamber/printermodels/SampleChamber.STL

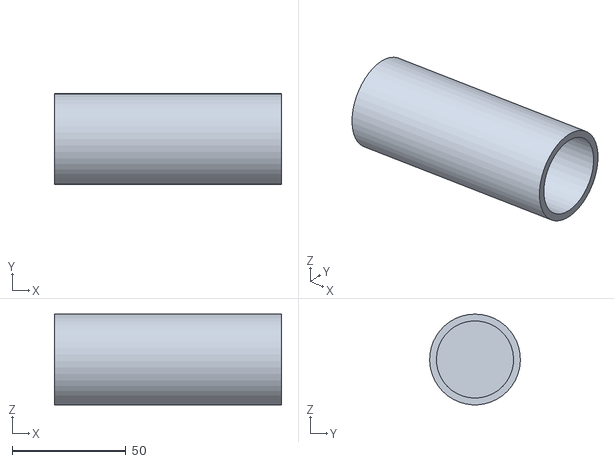
[picture p62: CAD file, 2019-04-02]
PayloadDesign/Chamber/printermodels/SampleChamber.STL
100.0 x 40.0 x 40.0
