WesternHAB/BioSampleBalloon/PayloadDesign/PayloadAssembly-July29/SyringeFilter.SLDPRT

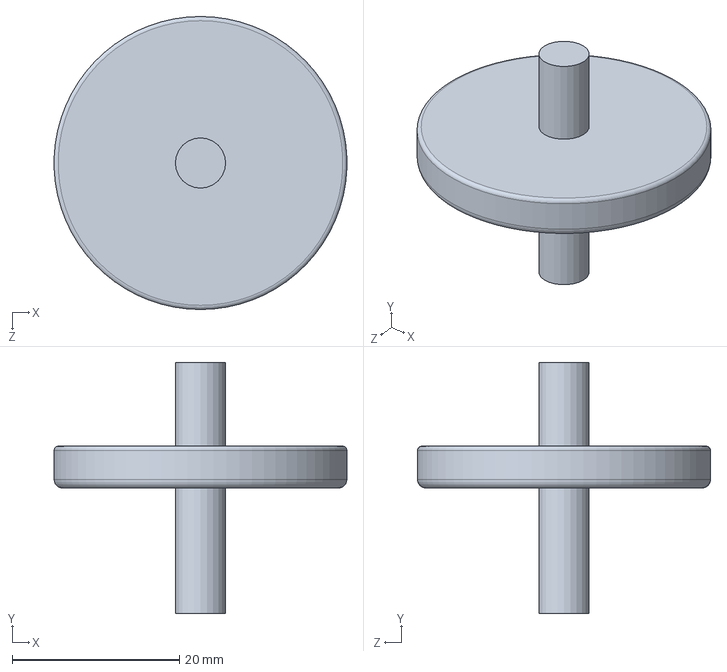
[picture p63: CAD file, 2019-08-02]
PayloadDesign/PayloadAssembly-July29/SyringeFilter.SLDPRT
35.0 x 30.0 x 35.0 mm
