WesternHAB/BioSampleBalloon/PayloadDesign/Chamber/printermodels/ChamberDoor.STL

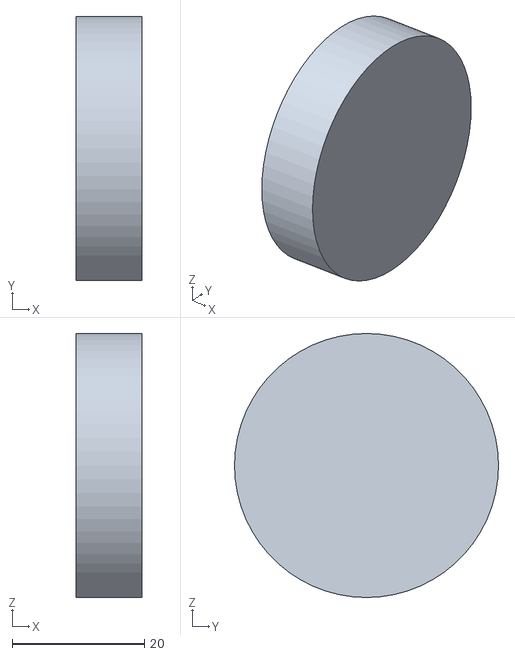
[picture p64: CAD file, 2019-04-02]
PayloadDesign/Chamber/printermodels/ChamberDoor.STL
10.0 x 40.0 x 40.0
