WesternHAB/BioSampleBalloon/PayloadDesign/Chamber/v2/L-Bracket.SLDPRT

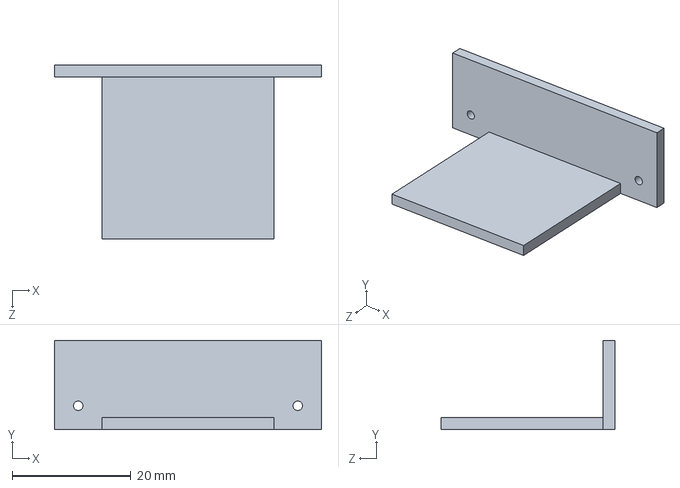
[picture p65: CAD file, 2019-07-11]
PayloadDesign/Chamber/v2/L-Bracket.SLDPRT
45.0 x 15.0 x 29.4 mm
