WesternHAB/BioSampleBalloon/PayloadDesign/PayloadAssembly-July29/ACTUONIX-P16-50-64-12-P_HOUSING.SLDPRT

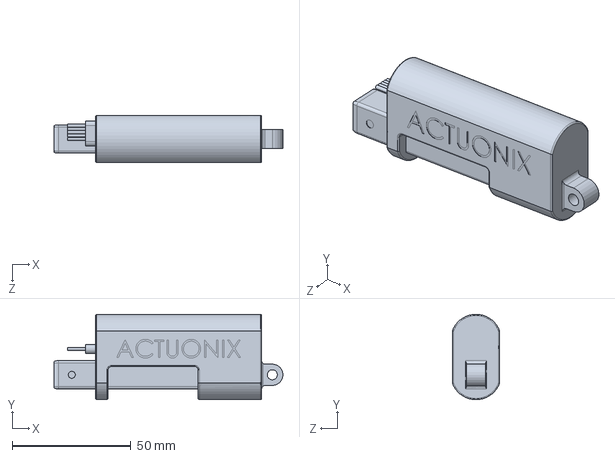
[picture p66: CAD file, 2019-08-02]
PayloadDesign/PayloadAssembly-July29/ACTUONIX-P16-50-64-12-P_HOUSING.SLDPRT
96.5 x 36.0 x 20.0 mm
