WesternHAB/BioSampleBalloon/PayloadDesign/Chamber/printermodels/HolderBase.STL

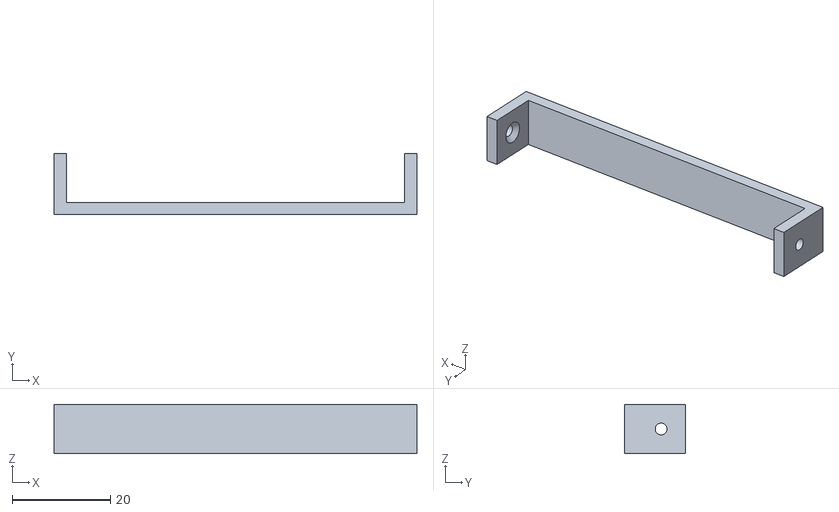
[picture p67: CAD file, 2019-04-02]
PayloadDesign/Chamber/printermodels/HolderBase.STL
74.0 x 12.5 x 10.0
