WesternHAB/BioSampleBalloon/PayloadDesign/Chamber/v2/Chamber.SLDPRT

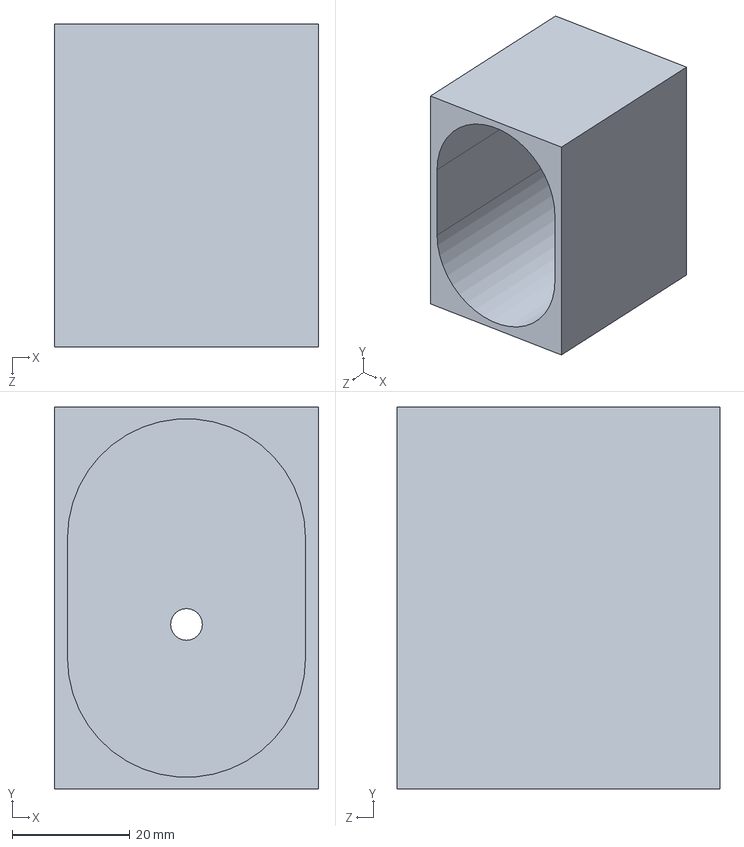
[picture p68: CAD file, 2019-07-11]
PayloadDesign/Chamber/v2/Chamber.SLDPRT
45.0 x 65.0 x 55.0 mm
