WesternHAB/BioSampleBalloon/PayloadDesign/Chamber/v2/RodHolder.SLDPRT

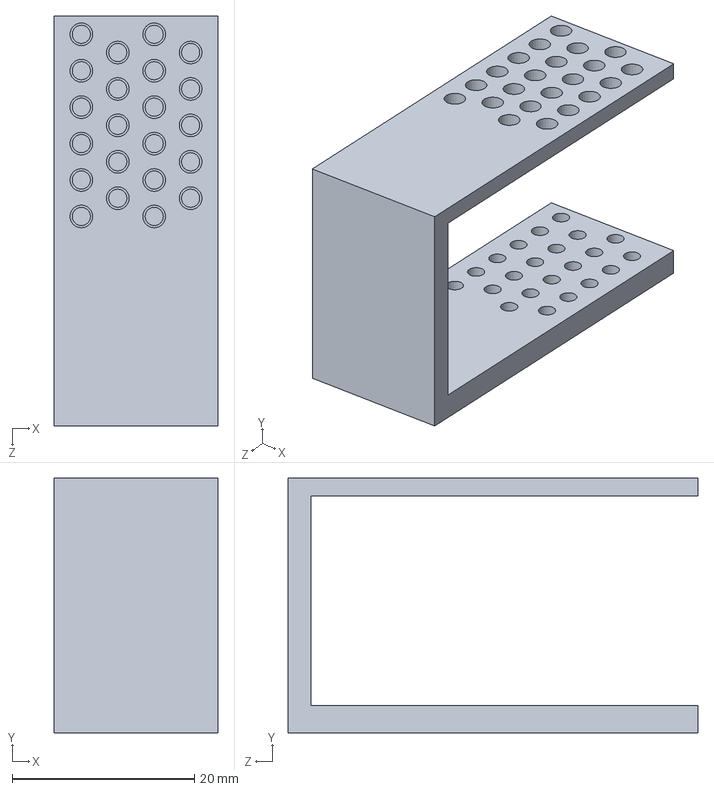
[picture p69: CAD file, 2019-07-03]
PayloadDesign/Chamber/v2/RodHolder.SLDPRT
18.0 x 28.0 x 45.0 mm
