WesternHAB/BioSampleBalloon/PayloadDesign/Chamber/v2/Gasket.SLDPRT

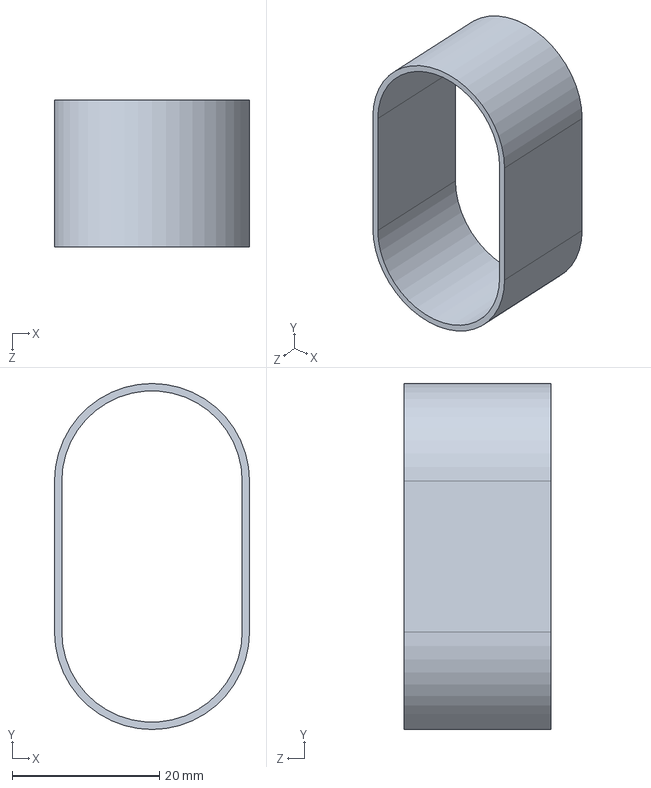
[picture p70: CAD file, 2019-06-27]
PayloadDesign/Chamber/v2/Gasket.SLDPRT
26.5 x 47.0 x 20.0 mm
