WesternHAB/BioSampleBalloon/PayloadDesign/PayloadAssembly-July29/BoxTop03.SLDPRT

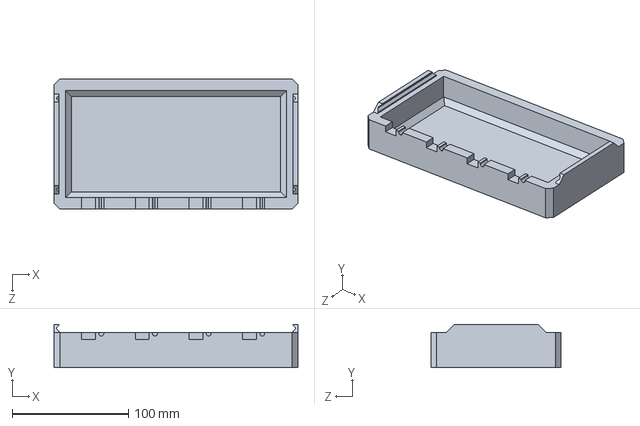
[picture p71: CAD file, 2019-08-02]
PayloadDesign/PayloadAssembly-July29/BoxTop03.SLDPRT
210.0 x 37.2 x 112.0 mm
