WesternHAB/BioSampleBalloon/PayloadDesign/PayloadAssembly-July29/BoxBottom02.SLDPRT

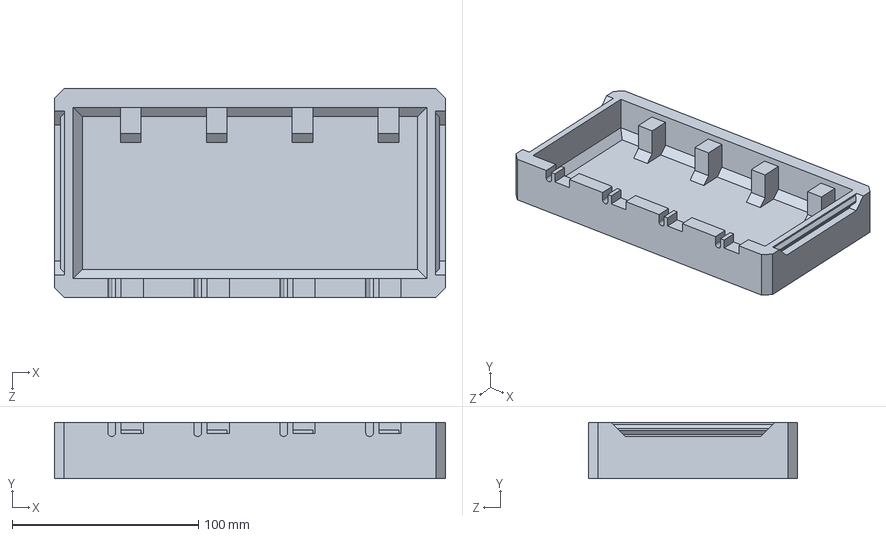
[picture p72: CAD file, 2019-08-02]
PayloadDesign/PayloadAssembly-July29/BoxBottom02.SLDPRT
210.0 x 30.2 x 112.0 mm
