WesternHAB/BioSampleBalloon/PayloadDesign/PayloadAssembly-July29/DoorBracket.SLDPRT

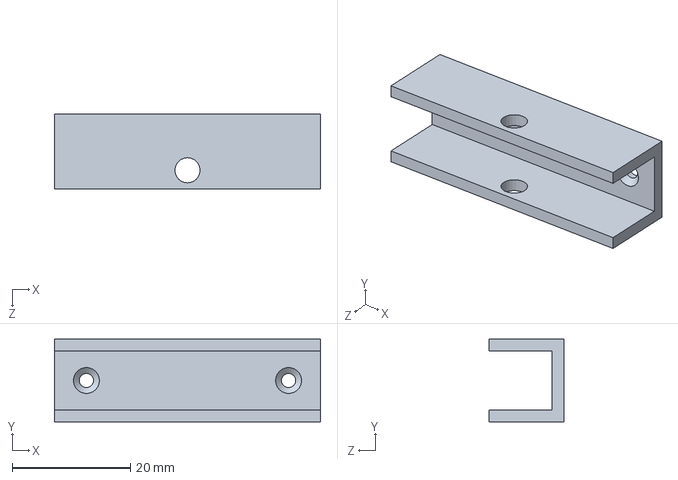
[picture p73: CAD file, 2019-08-02]
PayloadDesign/PayloadAssembly-July29/DoorBracket.SLDPRT
45.0 x 14.0 x 12.7 mm
