WesternHAB/BioSampleBalloon/PayloadDesign/PayloadAssembly-July29/Door.SLDPRT

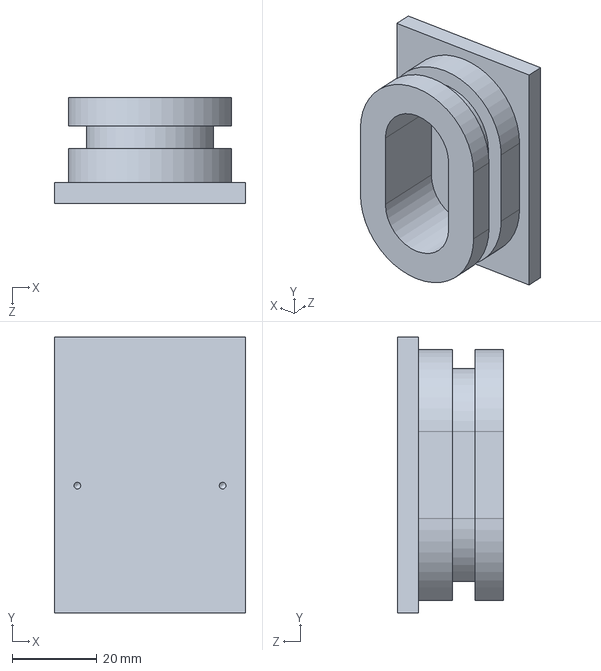
[picture p74: CAD file, 2019-08-02]
PayloadDesign/PayloadAssembly-July29/Door.SLDPRT
45.0 x 65.0 x 25.0 mm
