WesternHAB/BioSampleBalloon/PayloadDesign/PayloadAssembly-July29/ACTUONIX-P16-50-64-12-P_ROD.SLDPRT

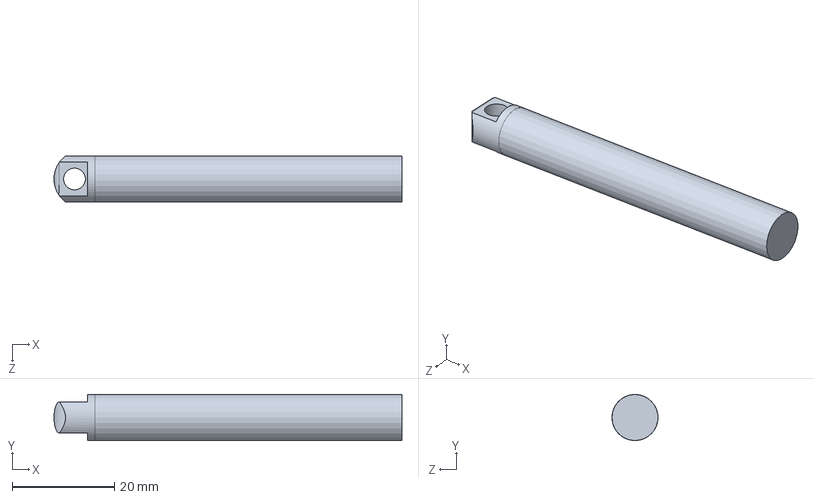
[picture p75: CAD file, 2019-08-02]
PayloadDesign/PayloadAssembly-July29/ACTUONIX-P16-50-64-12-P_ROD.SLDPRT
68.0 x 9.00 x 9.00 mm
