WesternHAB/BioSampleBalloon/PayloadDesign/PayloadAssembly-July29/NOGO-Zone.SLDPRT

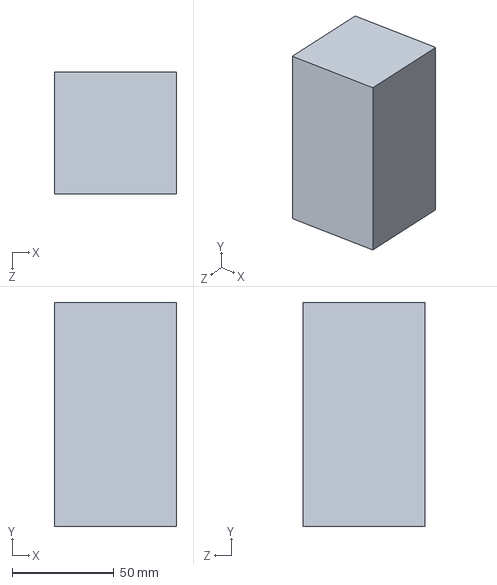
[picture p76: CAD file, 2019-08-02]
PayloadDesign/PayloadAssembly-July29/NOGO-Zone.SLDPRT
60.0 x 110.0 x 60.0 mm
