WesternHAB/BioSampleBalloon/PayloadDesign/PayloadAssembly-July29/deck.SLDPRT

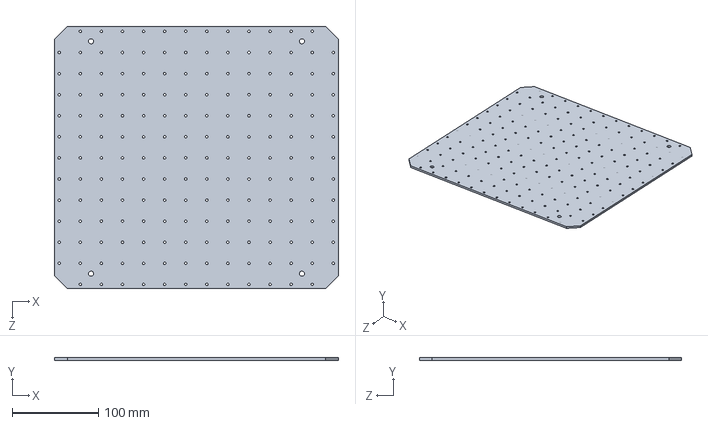
[picture p77: CAD file, 2019-08-02]
PayloadDesign/PayloadAssembly-July29/deck.SLDPRT
330.0 x 3.00 x 305.0 mm
