WesternHAB/BioSampleBalloon/PayloadDesign/PayloadAssembly-July29/HeatingPad.SLDPRT

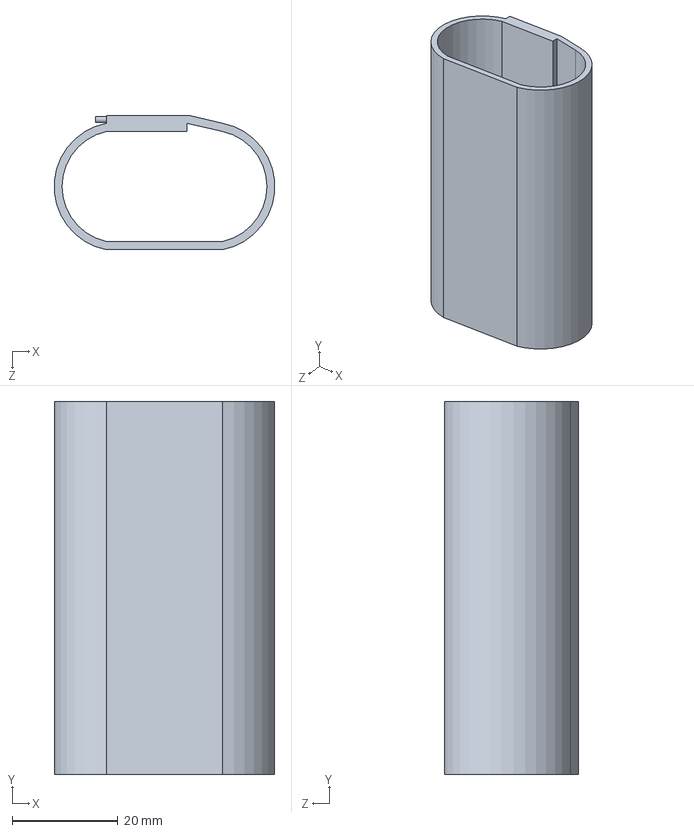
[picture p78: CAD file, 2019-08-02]
PayloadDesign/PayloadAssembly-July29/HeatingPad.SLDPRT
41.6 x 70.4 x 25.4 mm
