WesternHAB/BioSampleBalloon/PayloadDesign/PayloadAssembly-July29/L-Bracket.SLDPRT

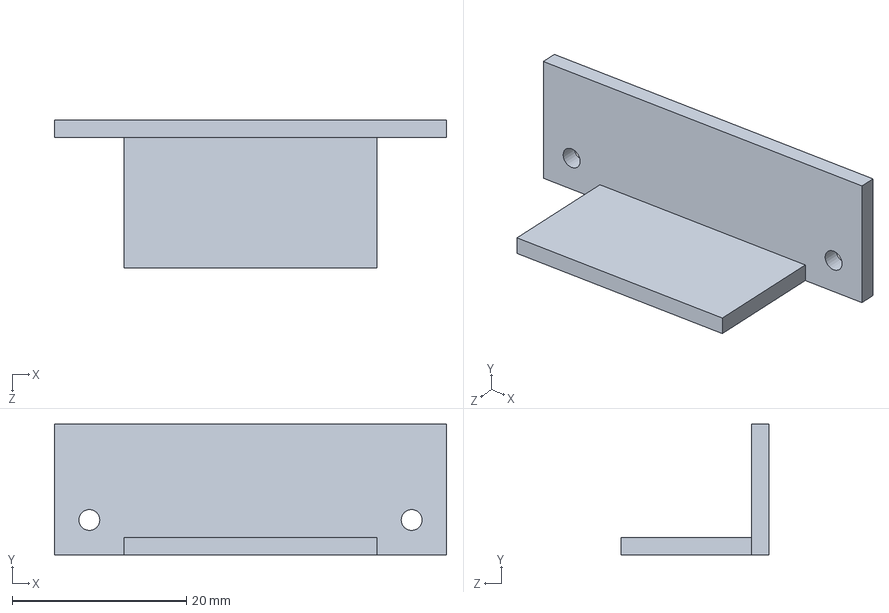
[picture p79: CAD file, 2019-08-02]
PayloadDesign/PayloadAssembly-July29/L-Bracket.SLDPRT
45.0 x 15.0 x 17.0 mm
