WesternHAB/BioSampleBalloon/PayloadDesign/PayloadAssembly-July29/Actuonix-P16-150-256-12-P-Shaft.SLDPRT

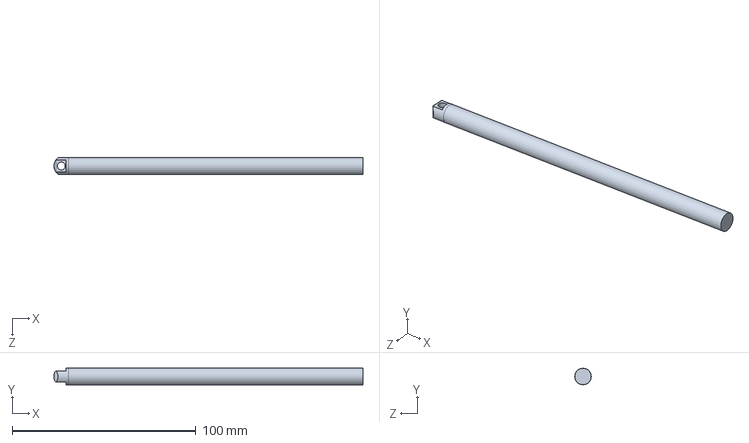
[picture p80: CAD file, 2019-06-05]
PayloadDesign/PayloadAssembly-July29/Actuonix-P16-150-256-12-P-Shaft.SLDPRT
168.0 x 9.00 x 9.00 mm
