WesternHAB/BioSampleBalloon/(list of files, cad)

Other CAD files:
PayloadDesign/PayloadAssembly-July29/ActuatorProxy.SLDASM
PayloadDesign/Actuonix-P16-150-256-12-P-Housing.STEP
PayloadDesign/PayloadAssembly-July29/ArduinoMega.SLDPRT
PayloadDesign/PayloadAssembly-July29/HBridge.SLDPRT
PayloadDesign/Chamber/v2/Rotorod.SLDPRT
PayloadDesign/PayloadAssembly-July29/Actuonix-P16-150-256-12-P-Housing.SLDPRT
PayloadDesign/PayloadAssembly-July29/RodHolder.SLDPRT
PayloadDesign/PayloadAssembly-July29/Chamber.SLDPRT
PayloadDesign/Chamber/v1/Catch.SLDPRT
PayloadDesign/Chamber/v1/ChamberAssembly.SLDASM
PayloadDesign/Chamber/v1/ChamberDoor.SLDDRW
PayloadDesign/Chamber/v1/ChamberDoor.SLDPRT
PayloadDesign/Chamber/v1/HolderBase.SLDDRW
PayloadDesign/Chamber/v1/HolderBase.SLDPRT
PayloadDesign/Chamber/v1/Latch.SLDPRT
PayloadDesign/Chamber/v1/RodHolder.SLDDRW
PayloadDesign/Chamber/v1/RodHolder.SLDPRT
PayloadDesign/Chamber/v1/SampleChamber.SLDDRW
PayloadDesign/Chamber/v1/SampleChamber.SLDPRT
PayloadDesign/Chamber/v2/Chamber.SLDDRW
PayloadDesign/Chamber/v2/Door.SLDDRW
PayloadDesign/Chamber/v2/RodHolder.SLDDRW
PayloadDesign/Chamber_legacy/v1/Catch.SLDPRT
PayloadDesign/Chamber_legacy/v1/ChamberAssembly.SLDASM
PayloadDesign/Chamber_legacy/v1/ChamberDoor.SLDDRW
PayloadDesign/Chamber_legacy/v1/ChamberDoor.SLDPRT
PayloadDesign/Chamber_legacy/v1/HolderBase.SLDDRW
PayloadDesign/Chamber_legacy/v1/HolderBase.SLDPRT
PayloadDesign/Chamber_legacy/v1/Latch.SLDPRT
PayloadDesign/Chamber_legacy/v1/RodHolder.SLDDRW
PayloadDesign/Chamber_legacy/v1/RodHolder.SLDPRT
PayloadDesign/Chamber_legacy/v1/SampleChamber.SLDDRW
PayloadDesign/Chamber_legacy/v1/SampleChamber.SLDPRT
PayloadDesign/Chamber_legacy/v2/Chamber.SLDDRW
PayloadDesign/Chamber_legacy/v2/Door.SLDDRW
PayloadDesign/Chamber_legacy/v2/RodHolder.SLDDRW
PayloadDesign/Chamber_legacy/v2/Rotorod.SLDPRT
PayloadDesign/PayloadAssembly-July29/DoorBracket.SLDDRW
PayloadDesign/PayloadAssembly-July29/L-Bracket.SLDDRW
PayloadDesign/l298n-h-bridge-motor-driver-1.snapshot.2/L298N Motor Driver.SLDPRT
PayloadDesign/st-st-toggle-latch/latch-702ss_asm.stl
