WesternHAB/BioSampleBalloon/PayloadDesign/Chamber/v2/assembly.PNG

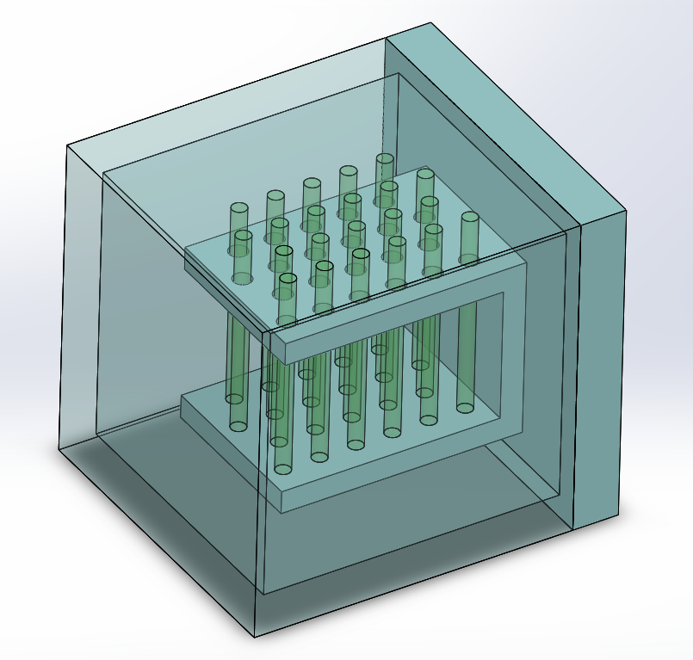
PayloadDesign/Chamber/v2/assembly.PNG
