WesternHAB/BioSampleBalloon/tests/freezerfulltest_jul31.ods

Timestamp | Direction | Position | Heating | Actuator Temperature | Outside Temperature
00:00:01 | extending | 720 | disabled | 24.254 | 24.03
00:00:02 | extending | 837 | disabled | 24.254 | 24.23
00:00:04 | extending | 956 | disabled | 24.254 | 24.26
00:00:05 | retracting | 1023 | disabled | 24.254 | 24.27
00:00:06 | retracting | 957 | disabled | 24.254 | 24.29
00:00:07 | retracting | 840 | disabled | 24.254 | 24.29
00:00:08 | retracting | 726 | disabled | 24.254 | 24.29
00:00:09 | retracting | 611 | disabled | 24.254 | 24.3
00:00:11 | retracting | 493 | disabled | 24.254 | 24.3
00:00:12 | retracting | 374 | disabled | 24.254 | 24.31
00:00:13 | retracting | 255 | disabled | 24.254 | 24.32
00:00:14 | retracting | 137 | disabled | 24.254 | 24.32
00:00:15 | retracting | 22 | disabled | 24.254 | 24.32
00:00:16 | extending | 0 | disabled | 24.254 | 24.33
00:00:18 | extending | 0 | disabled | 24.341 | 24.33
00:00:19 | extending | 86 | disabled | 24.341 | 24.33
00:00:20 | extending | 205 | disabled | 24.341 | 24.34
00:00:21 | extending | 324 | disabled | 24.341 | 24.33
00:00:22 | extending | 446 | disabled | 24.341 | 24.34
00:00:23 | extending | 565 | disabled | 24.341 | 24.34
00:00:25 | extending | 685 | disabled | 24.341 | 24.34
00:00:26 | extending | 800 | disabled | 24.341 | 24.34
00:00:27 | extending | 919 | disabled | 24.341 | 24.35
00:00:28 | retracting | 1023 | disabled | 24.341 | 24.35
00:00:29 | retracting | 923 | disabled | 24.341 | 24.35
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
00:43:01 | extending | 518 | disabled | 13.789 | -16.44
00:43:02 | extending | 622 | disabled | 13.789 | -16.45
00:43:03 | extending | 722 | disabled | 13.702 | -16.46
00:43:04 | extending | 823 | disabled | 13.702 | -16.46
00:43:06 | extending | 927 | disabled | 13.702 | -16.46
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
