WesternHAB/BioSampleBalloon/tests/freezeractuatortest_jul30.ods

Time(ms) | Direction | Position | Heating | Temperature(*C)
1932 | extending | 0 | disabled | 27.622
2067 | extending | 0 | disabled | 27.622
2201 | extending | 13 | disabled | 27.622
2336 | extending | 26 | disabled | 27.622
2475 | extending | 40 | disabled | 27.622
2609 | extending | 53 | disabled | 27.622
2744 | extending | 67 | disabled | 27.622
2881 | extending | 82 | disabled | 27.622
3015 | extending | 96 | disabled | 27.622
3150 | extending | 110 | disabled | 27.622
3286 | extending | 124 | disabled | 27.622
3426 | extending | 138 | disabled | 27.622
3562 | extending | 153 | disabled | 27.622
3698 | extending | 167 | disabled | 27.622
3835 | extending | 182 | disabled | 27.711
3971 | extending | 196 | disabled | 27.622
4105 | extending | 213 | disabled | 27.622
4271 | extending | 228 | disabled | 27.622
4406 | extending | 242 | disabled | 27.622
4541 | extending | 256 | disabled | 27.622
4677 | extending | 270 | disabled | 27.622
4815 | extending | 285 | disabled | 27.622
4955 | extending | 300 | disabled | 27.622
5090 | extending | 314 | disabled | 27.622
5228 | extending | 328 | disabled | 27.622
5364 | extending | 342 | disabled | 27.622
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
