WesternHAB/BioSampleBalloon/PayloadDesign/PayloadAssembly-July29/DoorBracket.PDF

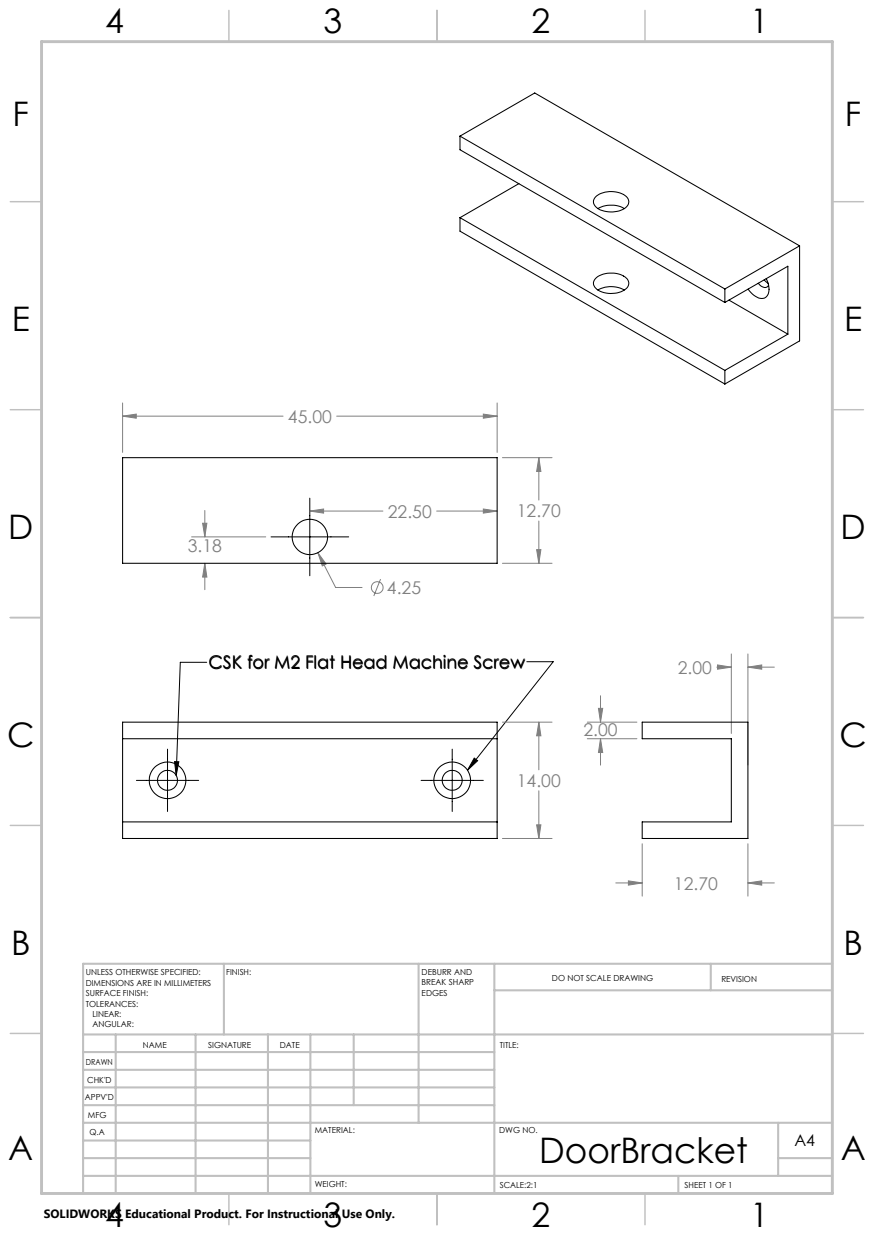
[picture p85: page 1]
FINISH:; DEBURR AND; BREAK SHARP; DO NOT SCALE DRAWING; REVISION; SCALE:2:1; SHEET 1 OF 1

CSK for M2 Flat Head Machine Screw

UNLESS OTHERWISE SPECIFIED:
DIMENSIONS ARE IN MILLIMETERS
SURFACE FINISH:
TOLERANCES:
LINEAR:
ANGULAR:

NAME | SIGNATURE | DATE | | | | TITLE:

DRAWN
CHK'D
APPV'D
MFG
Q.A | | | | MATERIAL: | DWG NO. DoorBracket | A4

SOLIDWORKS Educational Product. For Instructional Use Only.
