WesternHAB/BioSampleBalloon/PayloadDesign/PayloadAssembly-July29/L-Bracket.PDF

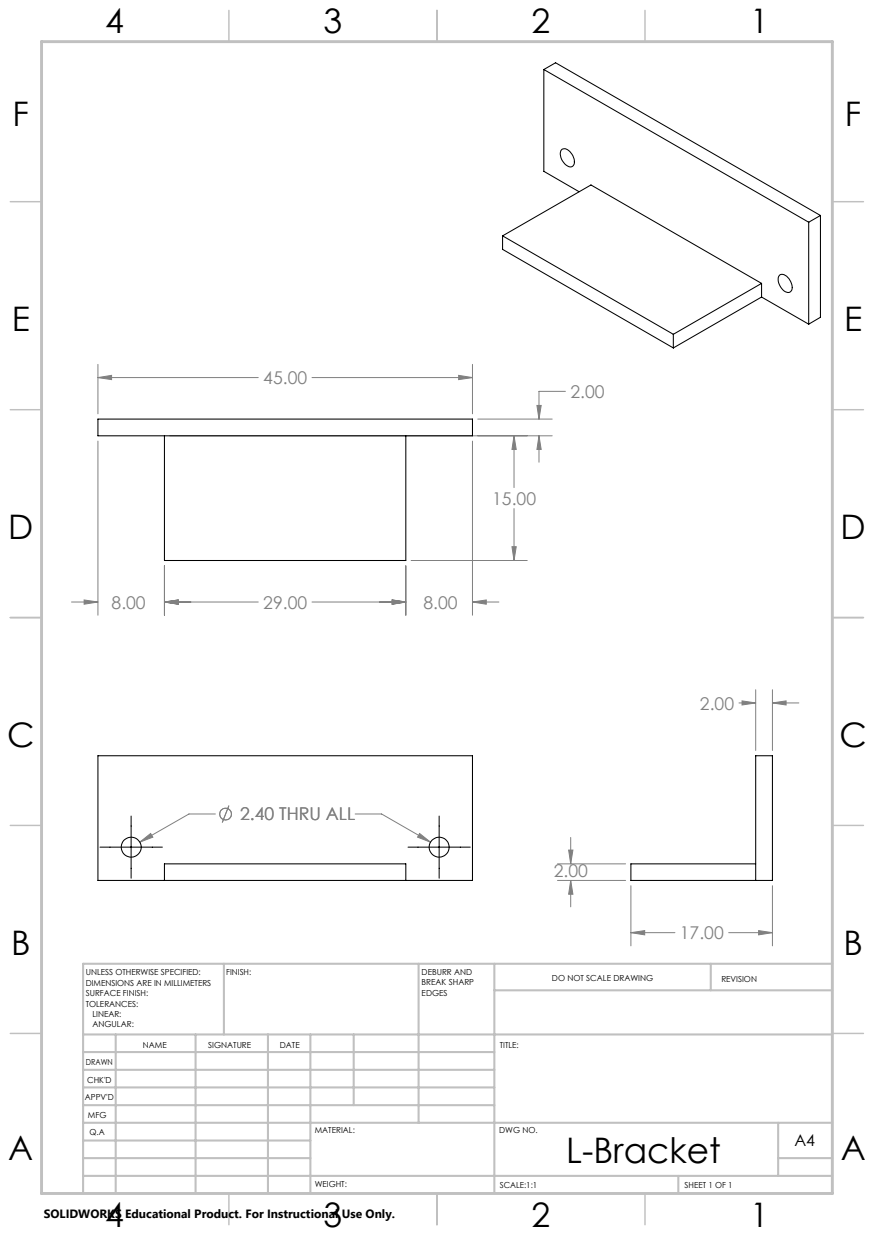
[picture p86: page 1]
2.40 THRU ALL; FINISH:; DEBURR AND; BREAK SHARP; DO NOT SCALE DRAWING; REVISION; SCALE:1:1; SHEET 1 OF 1

UNLESS OTHERWISE SPECIFIED:
DIMENSIONS ARE IN MILLIMETERS
SURFACE FINISH:
TOLERANCES:
LINEAR:
ANGULAR:

NAME | SIGNATURE | DATE | | | | TITLE:

DRAWN
CHK'D
APPV'D
MFG
Q.A | | | | MATERIAL: | DWG NO. L-Bracket | A4

SOLIDWORKS Educational Product. For Instructional Use Only.
