WesternHAB/BioSampleBalloon/PayloadDesign/Chamber/v2/Door.PDF

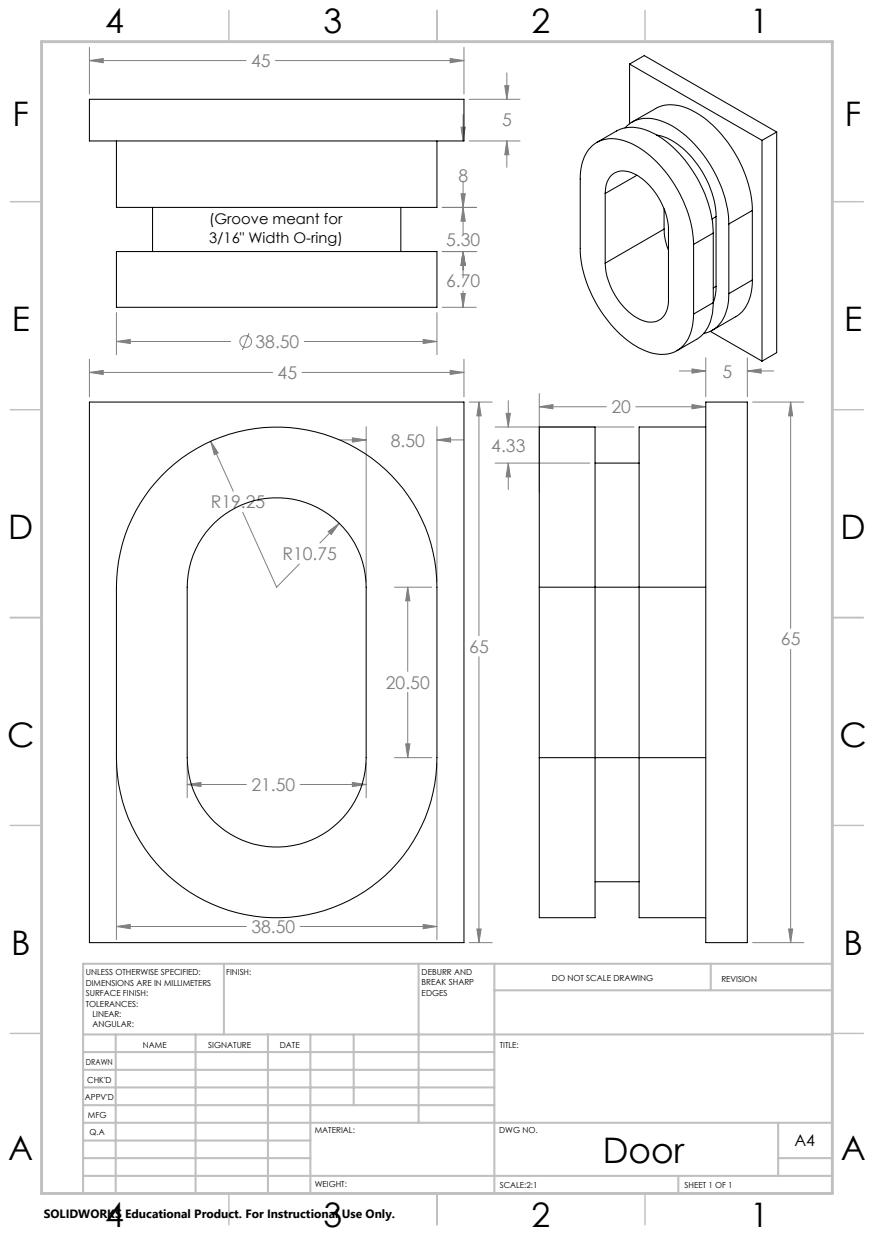
[picture p87: page 1]
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

(Groove meant for
3/16" Width O-ring)

UNLESS OTHERWISE SPECIFIED:
DIMENSIONS ARE IN MILLIMETERS
SURFACE FINISH:
TOLERANCES:
LINEAR:
ANGULAR:

NAME | SIGNATURE | DATE | | | | TITLE:

DRAWN
CHK'D
APPV'D
MFG
Q.A | | | | MATERIAL: | DWG NO. Door | A4

SOLIDWORKS Educational Product. For Instructional Use Only.
