WesternHAB/BioSampleBalloon/PayloadDesign/Chamber/v2/RodHolder.PDF

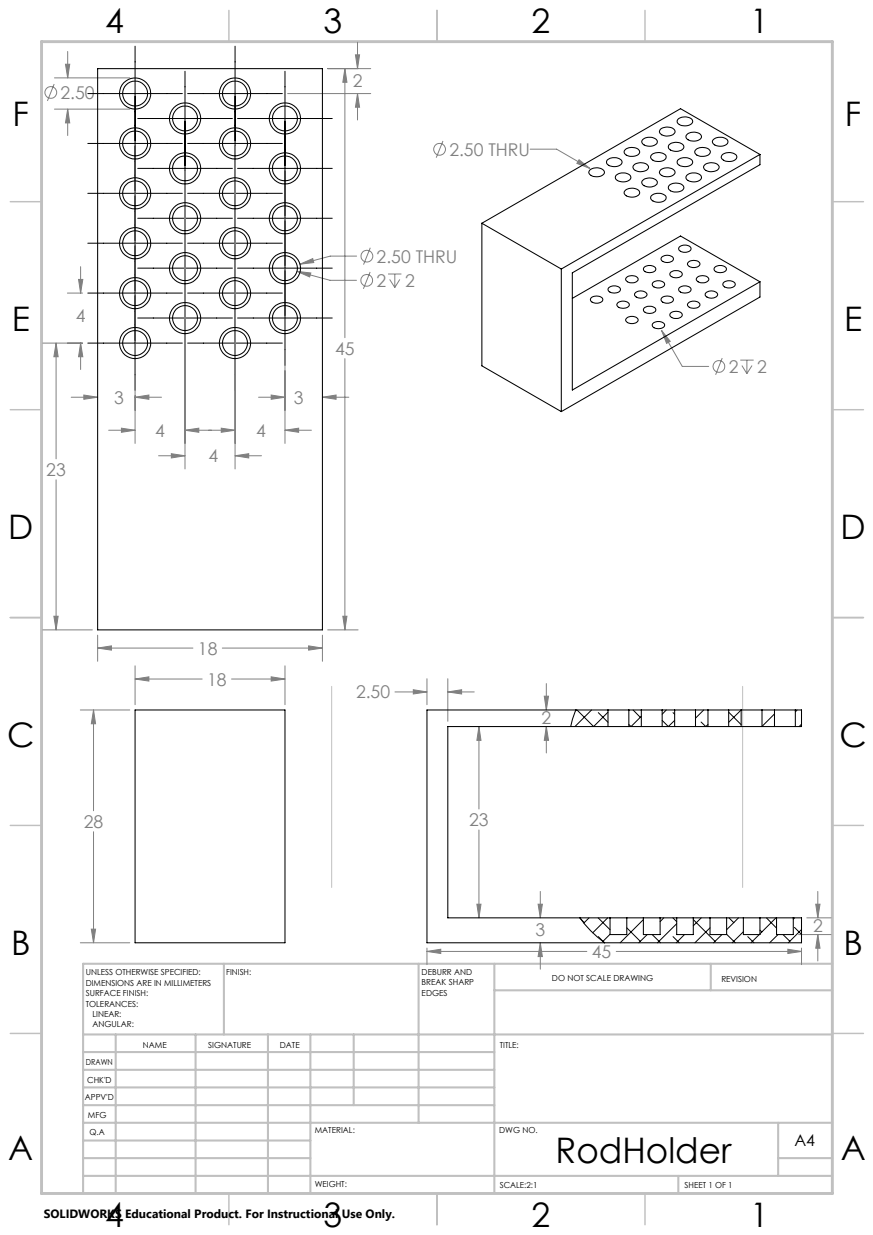
[picture p88: page 1]
2.50 THRU 2 2; 2.50 THRU; FINISH:; DEBURR AND; BREAK SHARP; DO NOT SCALE DRAWING; REVISION; SCALE:2:1; SHEET 1 OF 1

UNLESS OTHERWISE SPECIFIED:
DIMENSIONS ARE IN MILLIMETERS
SURFACE FINISH:
TOLERANCES:
LINEAR:
ANGULAR:

NAME | SIGNATURE | DATE | | | | TITLE:

DRAWN
CHK'D
APPV'D
MFG
Q.A | | | | MATERIAL: | DWG NO. RodHolder | A4

SOLIDWORKS Educational Product. For Instructional Use Only.
