WesternHAB/BioSampleBalloon/PayloadDesign/Chamber/O ring Groove/ChamberAssembly.PDF

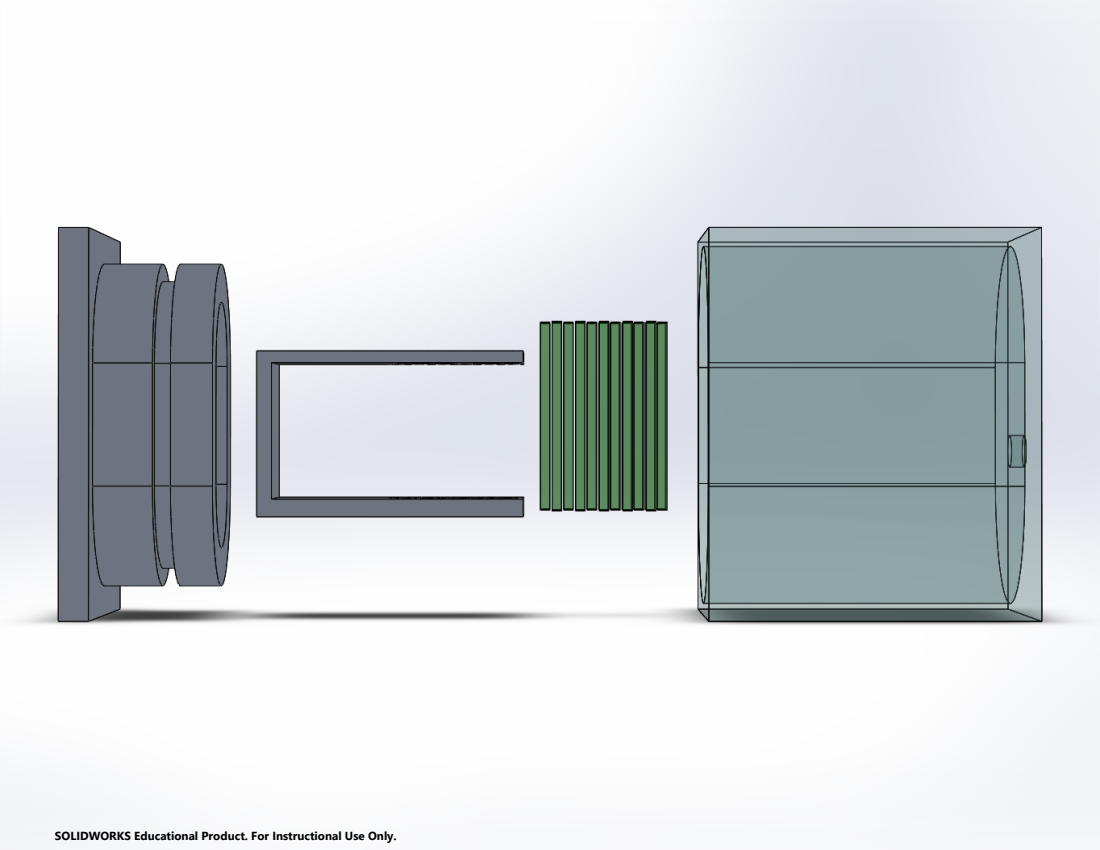
[picture p89: page 1]

SOLIDWORKS Educational Product. For Instructional Use Only.
