WesternHAB/BioSampleBalloon/PayloadDesign/Chamber/v1/SampleChamberV1.pdf

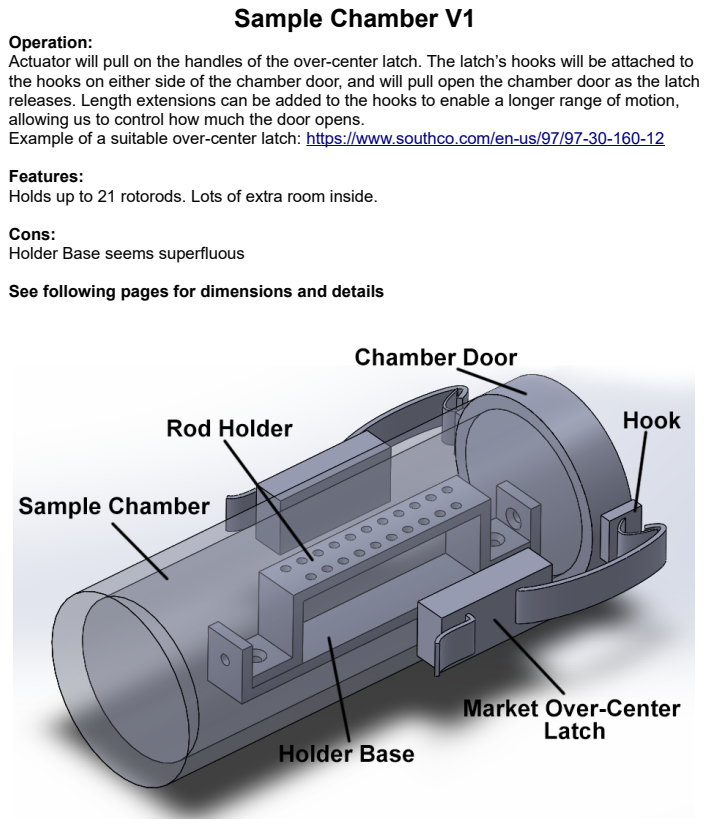
[picture p90: page 1]
Sample Chamber V1

Operation:
Actuator will pull on the handles of the over-center latch. The latch’s hooks will be attached to
the hooks on either side of the chamber door, and will pull open the chamber door as the latch
releases. Length extensions can be added to the hooks to enable a longer range of motion,
allowing us to control how much the door opens.
Example of a suitable over-center latch: https://www.southco.com/en-us/97/97-30-160-12

Features:
Holds up to 21 rotorods. Lots of extra room inside.

Cons:
Holder Base seems superfluous

See following pages for dimensions and details

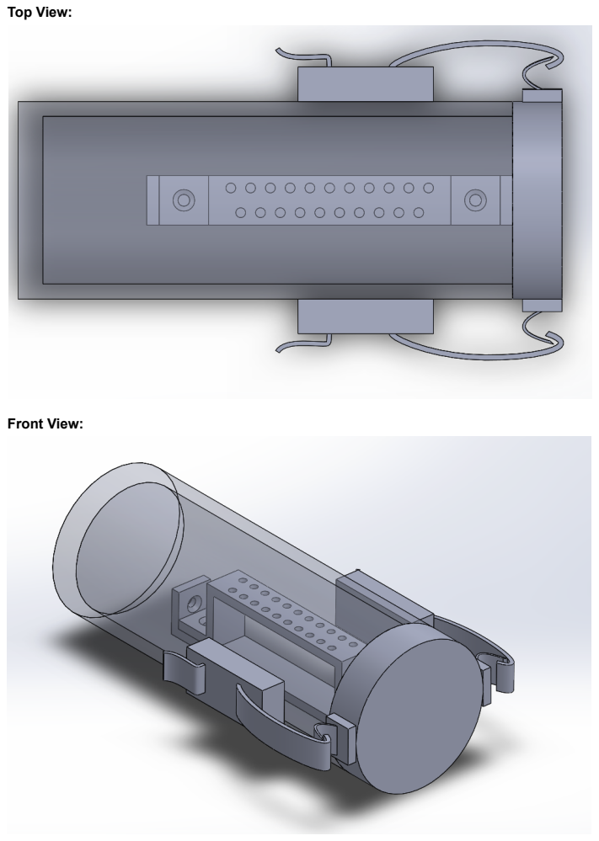
[picture p91: page 2]
Top View:; Front View:

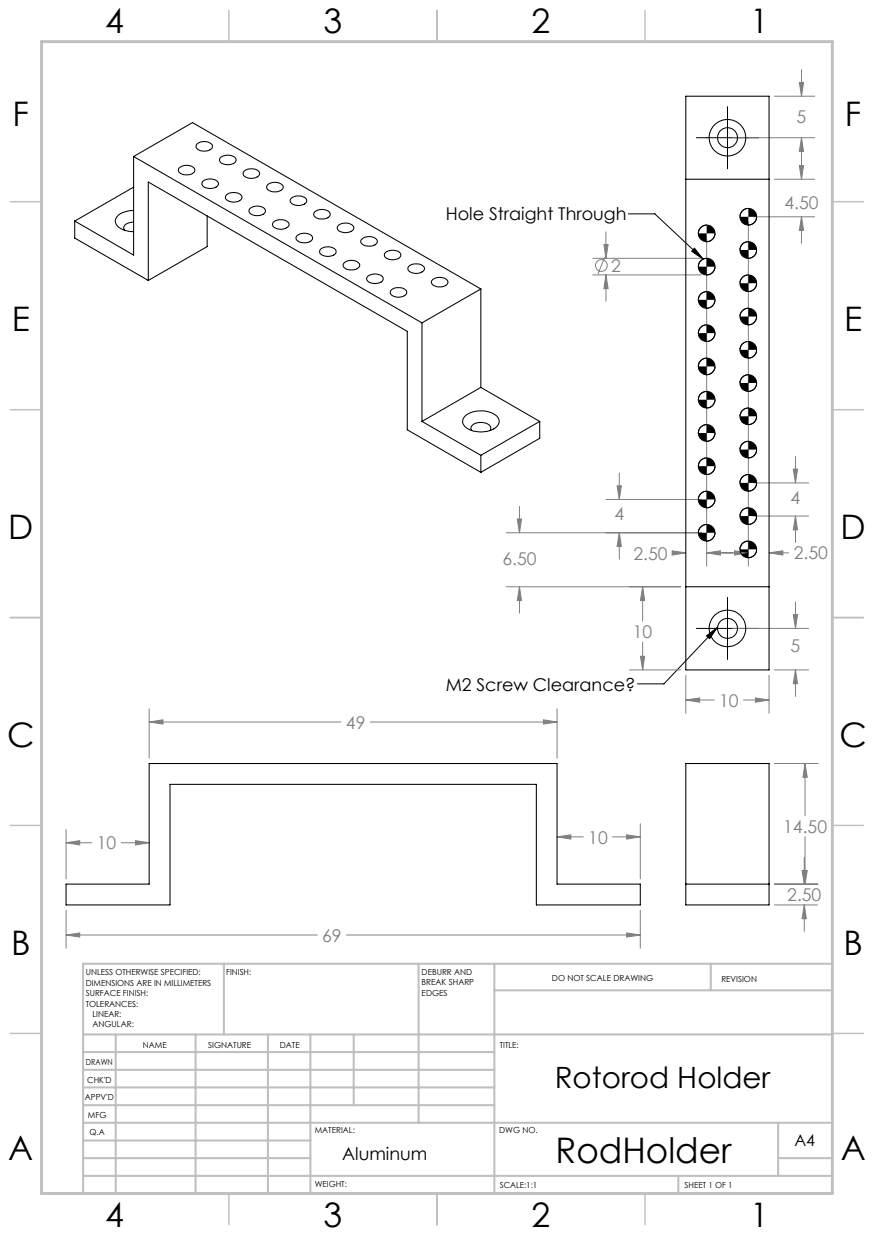
[picture p92: page 3]
M2 Screw Clearance?; FINISH:; DEBURR AND; BREAK SHARP; DO NOT SCALE DRAWING; REVISION; SCALE:1:1; SHEET 1 OF 1

Hole Straight Through

UNLESS OTHERWISE SPECIFIED:
DIMENSIONS ARE IN MILLIMETERS
SURFACE FINISH:
TOLERANCES:
LINEAR:
ANGULAR:

NAME | SIGNATURE | DATE | | | | TITLE: Rotorod Holder

DRAWN
CHK'D
APPV'D
MFG
Q.A | | | | MATERIAL: Aluminum | DWG NO. RodHolder | A4

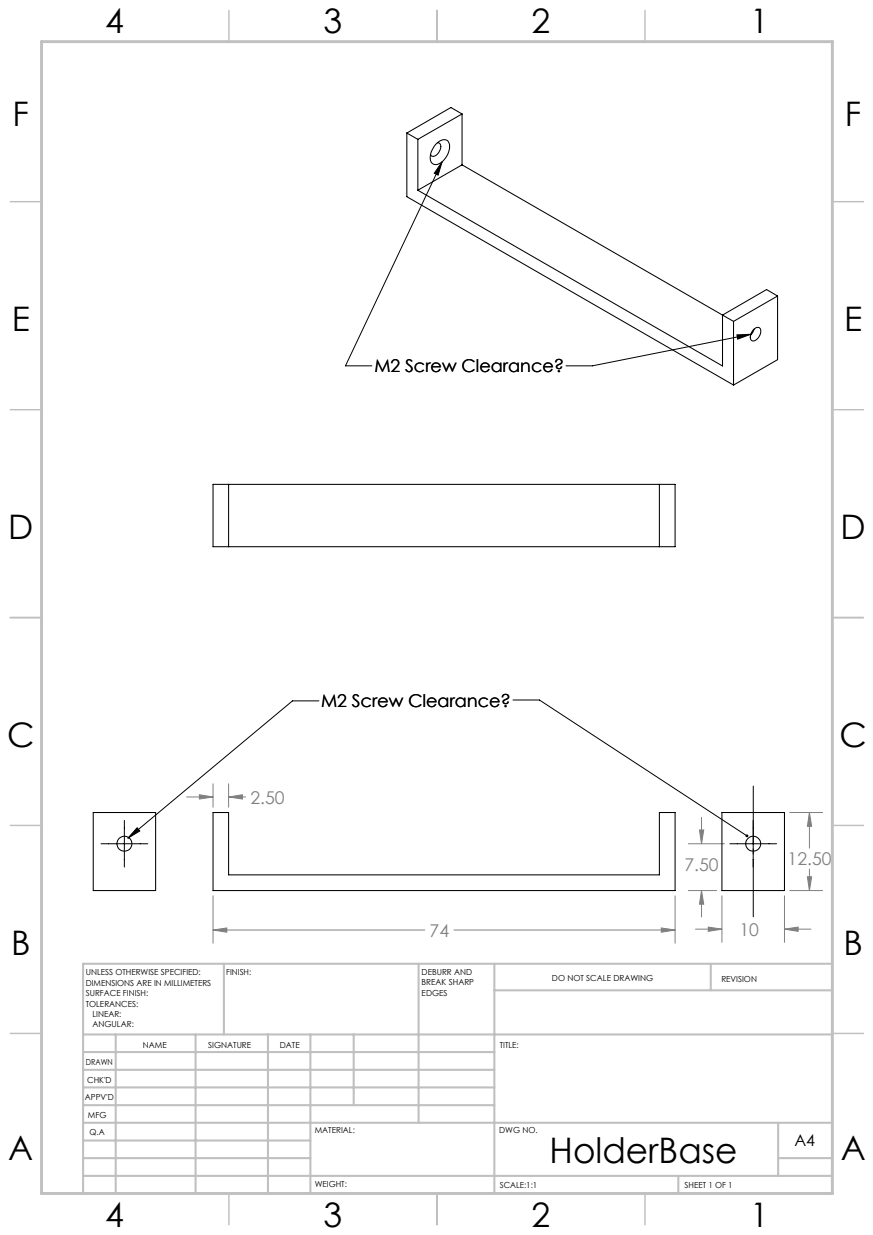
[picture p93: page 4]
M2 Screw Clearance?; FINISH:; DEBURR AND; BREAK SHARP; DO NOT SCALE DRAWING; REVISION

UNLESS OTHERWISE SPECIFIED:
DIMENSIONS ARE IN MILLIMETERS
SURFACE FINISH:
TOLERANCES:
LINEAR:
ANGULAR:

NAME | SIGNATURE | DATE | | | TITLE:

DRAWN
CHK'D
APPV'D
MFG

HolderBase

SCALE:1:1 | SHEET 1 OF 1

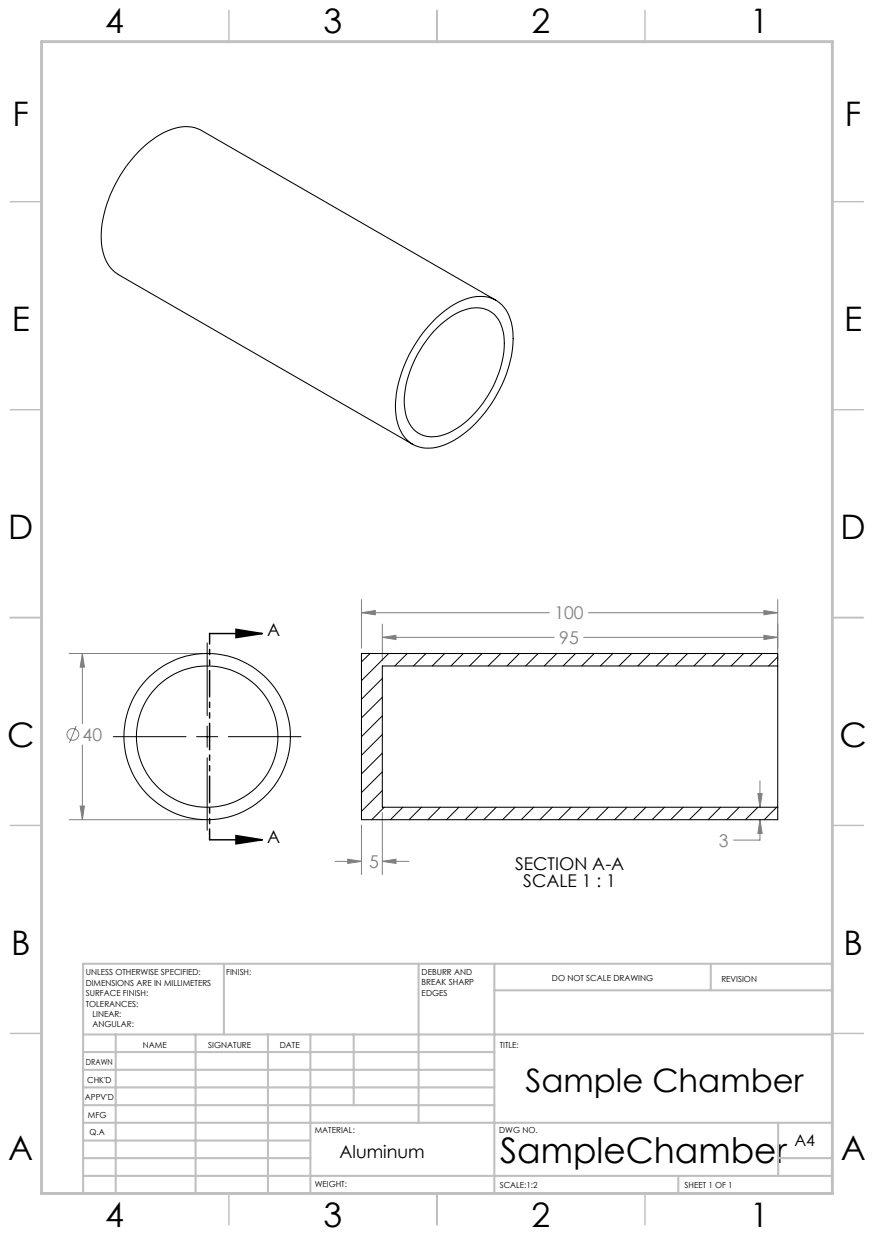
[picture p94: page 5]
SECTION A-A SCALE 1 : 1; FINISH:; DEBURR AND; BREAK SHARP; DO NOT SCALE DRAWING; REVISION

UNLESS OTHERWISE SPECIFIED:
DIMENSIONS ARE IN MILLIMETERS
SURFACE FINISH:
TOLERANCES:
LINEAR:
ANGULAR:

NAME | SIGNATURE | DATE | | | TITLE: Sample Chamber

DRAWN
CHK'D
APPV'D
MFG

SampleChamber

SCALE:1:2 | SHEET 1 OF 1

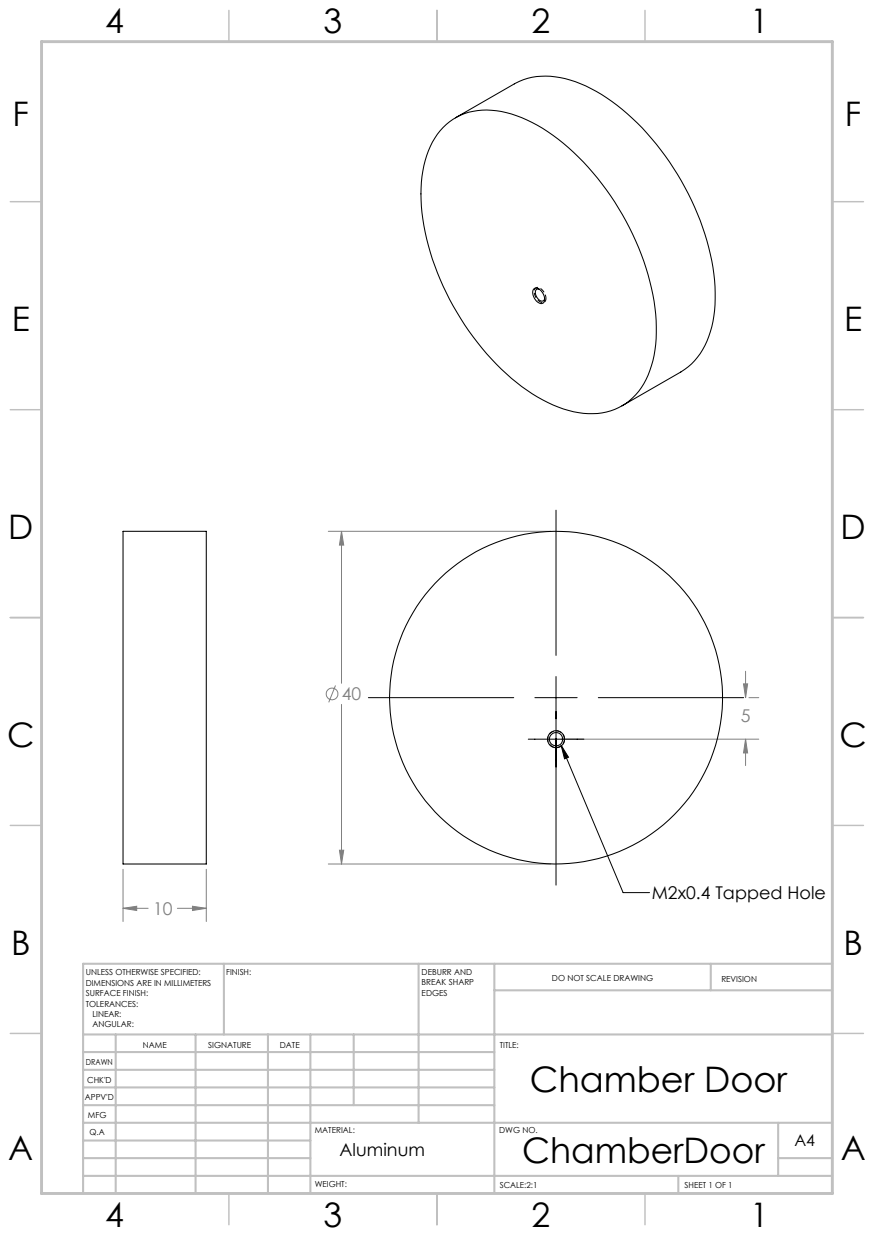
[picture p95: page 6]
M2x0.4 Tapped Hole; FINISH:; DEBURR AND; BREAK SHARP; DO NOT SCALE DRAWING; REVISION

UNLESS OTHERWISE SPECIFIED:
DIMENSIONS ARE IN MILLIMETERS
SURFACE FINISH:
TOLERANCES:
LINEAR:
ANGULAR:

NAME | SIGNATURE | DATE | | | TITLE: Chamber Door

DRAWN
CHK'D
APPV'D
MFG

ChamberDoor

SCALE:2:1 | SHEET 1 OF 1
