WesternHAB/BioSampleBalloon/(commit log)

2019-03-04 add wip drawings of the sample chamber
    [ChamberAssembly.SLDASM, ChamberDoor.SLDDRW, ChamberDoor.SLDPRT, HolderBase.SLDDRW, HolderBase.SLDPRT, RodHolder.SLDDRW, RodHolder.SLDPRT, SampleChamber.SLDDRW]
2019-03-07 drawings with over center latch
    [Catch.SLDPRT, ChamberAssembly.SLDASM, ChamberDoor.SLDPRT, Latch.SLDPRT]
2019-03-15 pdr info, mass budget, drawings, report, and slideshow
    [Mass and Power Budget.xlsx]
2019-03-27 Added Pin definitions for Actuator controls
2019-03-29 add 3d printer models
    [ChamberDoor.STL, HolderBase.STL, RodHolder.STL, SampleChamber.STL]
2019-04-02 Updating Software Prototype
2019-04-02 Adding Circuit Diagram
2019-04-02 misc paperwork stuff
    [COM.ods, Mass and Power Budget.xlsx]
2019-04-03 3d print photos
2019-04-03 reorganize structure
    [Catch.SLDPRT, ChamberAssembly.SLDASM, ChamberDoor.SLDDRW, ChamberDoor.SLDPRT, ChamberDoor.STL, HolderBase.SLDDRW, HolderBase.SLDPRT, HolderBase.STL]
2019-04-29 v2 chamber wip
    [Catch.SLDPRT, ChamberAssembly.SLDASM, ChamberDoor.SLDDRW, ChamberDoor.SLDPRT, HolderBase.SLDDRW, HolderBase.SLDPRT, Latch.SLDPRT, RodHolder.SLDDRW]
2019-05-01 assembly v2
    [Chamber.SLDPRT, ChamberAssembly.SLDASM, Door.SLDPRT, RodHolder.SLDPRT, Rotorod.SLDPRT]
2019-05-02 update with longer rod dimensions
    [Chamber.SLDPRT, ChamberAssembly.SLDASM, Door.SLDPRT, Rotorod.SLDPRT]
2019-05-10 add drawings
    [Chamber.SLDDRW, Door.SLDDRW, RodHolder.SLDDRW]
2019-06-05 reorganizing, tweaked chamber design, payload layout drawings
    [ActuatorProxy.SLDASM, Actuonix-P16-150-256-12-P-Housing.SLDPRT, Actuonix-P16-150-256-12-P-Housing.STEP, Actuonix-P16-150-256-12-P-Shaft.SLDPRT, Actuonix-P16-150-256-12-P.SLDASM, ArduinoMega.SLDPRT, ArduinoMega_STEP_AP203.STEP, Catch.SLDPRT]
2019-06-06 ridged chamber design for silicon gasket
    [Chamber.SLDPRT, ChamberAssembly.SLDASM, Door.SLDPRT, Payload.SLDASM, RodHolder.SLDPRT]
2019-06-09 slotted chamber for trim to form an actual seal
    [Chamber.SLDDRW, Chamber.SLDPRT, ChamberAssembly.SLDASM, Door.SLDDRW, Door.SLDPRT, Payload.SLDASM, RodHolder.SLDDRW, RodHolder.SLDPRT]
2019-06-10 slightly larger chamber
    [Chamber.SLDDRW, Chamber.SLDPRT, ChamberAssembly.SLDASM, Door.SLDDRW, Door.SLDPRT]
2019-06-12 longer ridge
    [Chamber.SLDDRW, Chamber.SLDPRT, ChamberAssembly.SLDASM, Door.SLDDRW, Door.SLDPRT, Payload.SLDASM, RodHolder.SLDDRW, RodHolder.SLDPRT]
2019-06-24 chamber a little bigger, add luer lock hole
    [Chamber.SLDDRW, Chamber.SLDPRT, ChamberAssembly.SLDASM]
2019-06-26 Flight software
    Partial implementation of the flight software. The test flight software implements some parts of the libraries below; is not the final version.
    Working implementations of custom libraries for Camera, Actuator, GPS/GPS_Manager, Logging.
    Telnet command lib still in progress,
2019-06-27 fancy new rodholder, sexy af
    [Chamber.SLDDRW, Chamber.SLDPRT, ChamberAssembly.SLDASM, Door.SLDPRT, RodHolder.SLDDRW, RodHolder.SLDPRT, Rotorod.SLDPRT]
2019-06-27 gasket wip
    [Gasket.SLDPRT]
2019-07-03 Adding updates to drawings
    [Actuonix-P16-150-256-12-P-Housing.STEP, ArduinoMega_STEP_AP203.STEP, Chamber.SLDPRT, ChamberAssembly.SLDASM, Door.SLDDRW, Door.SLDPRT, L298N Motor Driver.STEP, RodHolder.SLDPRT]
2019-07-11 Pushing holes and brackets
    [Chamber.SLDPRT, L-Bracket.SLDPRT, L-bracketAssembly.SLDASM]
2019-07-29 door for 3/16width oring
    [Door.SLDDRW, Door.SLDPRT]
2019-07-29 Contains all parts needed to build in SolidWorks
    Shorter actuators and actuator enclosure included
2019-07-29 Add files via upload
    Updated mates and added door bracket
2019-07-29 Add files via upload
    Updated chamber locations, actuator box positions, included No-Go zone, updated mates
2019-07-30 add freezer test data and graphs
    [freezeractuatortest_jul30.ods]
2019-08-01 add second freezer test data
    [freezerfulltest_jul31.ods]
2019-08-02 final door bracket, L-bracket, syringe filters, and assembly w/ control chamber
    * reorganized folders
    [ACTUONIX-P16-50-64-12-P.SLDASM, ACTUONIX-P16-50-64-12-P_HOUSING.SLDPRT, ACTUONIX-P16-50-64-12-P_ROD.SLDPRT, ActuatorProxy.SLDASM, Actuonix-P16-150-256-12-P-Housing.SLDPRT, Actuonix-P16-150-256-12-P-Shaft.SLDPRT, ArduinoMega.SLDPRT, BoxActuatorHeatingPad.SLDASM]
2019-08-09 Software additions
    Most required features now implemented.
    A temporary groundstation server is used for testing commands, but a proper implementation is required.
    UDP multicast and integration with CSA's PRISM system is still required.
    General stress/usage testing with simulated GPS readouts is required to ensure the program will operate correctly throughout the flight.
    [HAB_interval_logging.ino, camera_logging_test.ino, camera_test.ino, flight_software.ino, flight_software_test.ino, gps_lib_test.ino, gps_manager_test.ino, gps_partial_test.ino]
2019-08-21 Add files via upload
    Updated Payload assembly with fan ducts
2019-08-26 Software backup
    Fixed auto-mode and command bugs
    [flight_software.ino]
2019-08-29 Power control files
